OxMarco/Quiesco/README.md

<div align="center">

<picture>
  <source media="(prefers-color-scheme: dark)" srcset=".github/assets/banner-dark.svg">
  Quiesco: an open-source bedroom environment monitor
</picture>

<br><br>





<br>




**[Build your own](#-build-your-own)** · **[Hardware](hardware/)** · **[Firmware](firmware/)** · **[App](app/)**

</div>

---

Quiesco is a pocket-sized monitor made for the room you sleep in. It measures
**CO₂, temperature, humidity, light and noise**, shows them on an e-ink screen
that reads from across the room, and syncs every night to your phone over
Bluetooth. There is no Wi-Fi, no cloud and no account: your data stays yours.

Everything is open. This repository holds the PCB, the case, the firmware and
the companion app, so you can build one from scratch, reflash it from the
Arduino toolchain, or take it apart and make it your own.

Quiesco is a product of [Impossible Labs](https://impossiblelabs.xyz).

<p align="center">
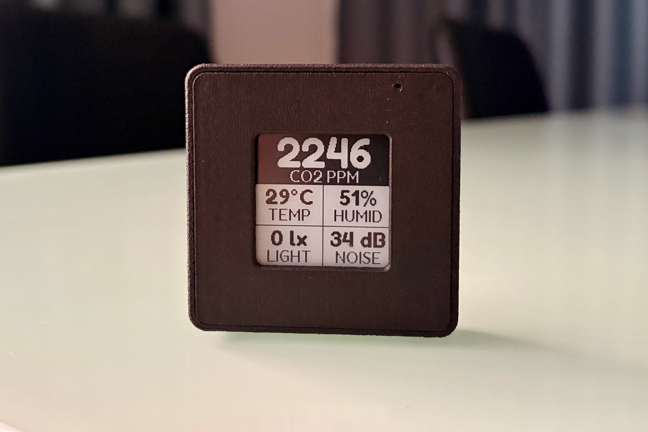
[picture p1: .github/assets/quiesco-front.jpg]
A Quiesco unit standing on a table, its e-ink screen showing CO₂, temperature, humidity, light and noise
  
</p>

<picture>
  <source media="(prefers-color-scheme: dark)" srcset=".github/assets/screens-dark.svg">
  The three e-ink screens: Face, Ledger and Bento
</picture>

## Contents

- [Why Quiesco](#-why-quiesco)
- [What it measures](#-what-it-measures)
- [How it works](#-how-it-works)
- [Specs](#-specs)
- [Build your own](#-build-your-own)
- [Upgrade firmware](#-upgrade-firmware)
- [Repository map](#-repository-map)
- [Roadmap](#-roadmap)
- [The story behind it](#-the-story-behind-it)
- [Contributing](#-contributing)
- [Licence](#-licence)

## 🌙 Why Quiesco

Environmental monitors have boomed: Aranet, Airvalent and friends made CO₂
tracking friendly. But they are general-purpose. They watch the air, and
little else, against office standards.

Quiesco is built for the **bedroom**. Light and noise matter as much as CO₂ and
temperature for a good night, so it measures all of them and judges each one
against a comfort band. Every reading is **actionable**:

| When it says… | …you can |
|---|---|
| CO₂ is high | open a window or run ventilation |
| too warm, too cold | adjust heating, cooling or bedding |
| too dry, too damp | humidify or dehumidify |
| too much light | close the blinds or wear a sleep mask |
| too loud | check the insulation or reach for earplugs |

And unlike commercial devices, it is **completely open and unlocked**: it runs
the Arduino bootloader, so you can change the firmware with the Arduino IDE or
your favourite editor.

## 📊 What it measures

| Reading | Sensor | Comfortable | Warn | Bad |
|---|---|---|---|---|
| CO₂ | Sensirion **SCD41** (photoacoustic NDIR) | ≤ 800 ppm | 800–1000 ppm | > 1000 ppm |
| Temperature | Bosch **BME280** | 16–20 °C | 14–16 · 20–24 °C | < 14 · > 24 °C |
| Humidity | Bosch **BME280** | 40–60 % | 30–40 · 60–70 % | < 30 · > 70 % |
| Noise | Knowles **SPH0641LU4H-1** PDM mic, dB(A) Leq over ~7 s | ≤ 45 dB | 45–55 dB | > 55 dB |
| Light | Vishay **VEML7700** | informational | | |
| Pressure | Bosch **BME280** | informational; also compensates CO₂ | | |

The same bands drive the e-ink screen and the app, so the phone and the panel
always agree. The full policy is in [`firmware/UI.md`](firmware/UI.md#3-comfort-bands).

> [!IMPORTANT]
> Keep the unit out of direct sunlight. Sun on the case heats the sensors, so
> temperature reads several degrees high and humidity reads low. On a test
> bench, afternoon sun pushed the reading to 36 °C. A shaded bedside table or
> shelf, away from radiators and air vents, gives readings you can trust.

## ⚙ How it works

```mermaid
flowchart LR
    subgraph unit["Quiesco unit · nRF52840"]
        direction TB
        rail["Switched sensor rail"] --> sensors["SCD41 · BME280<br/>VEML7700 · PDM mic"]
        sensors --> cycle["Measurement cycle"]
        cycle --> flash[("8 MB flash<br/>sample log")]
        cycle --> eink["1.54″ e-ink<br/>Face · Ledger · Bento"]
        cycle --> ble["BLE service"]
        flash --> ble
    end
    ble <-- "authenticated, enrolled over USB" --> app["Companion app<br/>iOS · Android"]
    app --> db[("SQLite<br/>on your phone")]
```

Every interval (1, 5, 10 or 30 minutes; default **5 minutes**) the unit powers
up its sensor rail, measures everything, applies your calibration offsets,
appends the reading to its on-board log, redraws the e-ink panel only if the
picture changed, then powers the rail down and sleeps. A sensor that fails is
reported as unavailable, and the cycle carries on without it.

The app enrols with a unit while it is on USB power, using a six-digit code
shown on the panel. After that it sets the clock, downloads the log, charts
each night and lets you pick the screen or calibrate the sensors. One phone
can hold several units, each with its own name and sleep window.

## 📐 Specs

<p align="center">
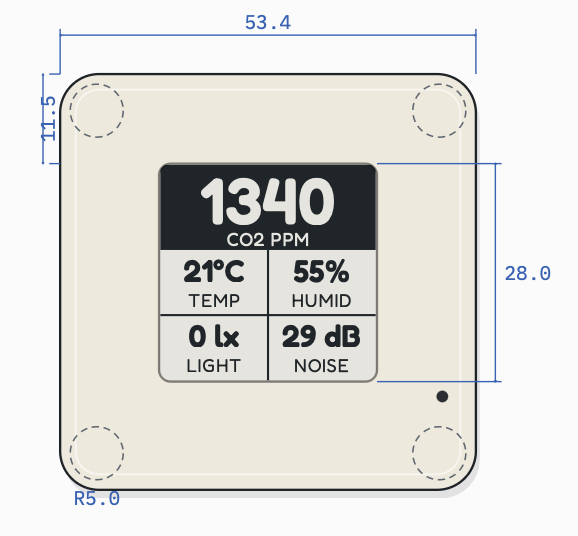
[picture p2: .github/assets/enclosure-front.png]
Front view of the enclosure: 53.4 mm square with 5 mm corner radii and a 28 mm e-ink window showing CO₂, temperature, humidity, light and noise
  
</p>

<p align="center">
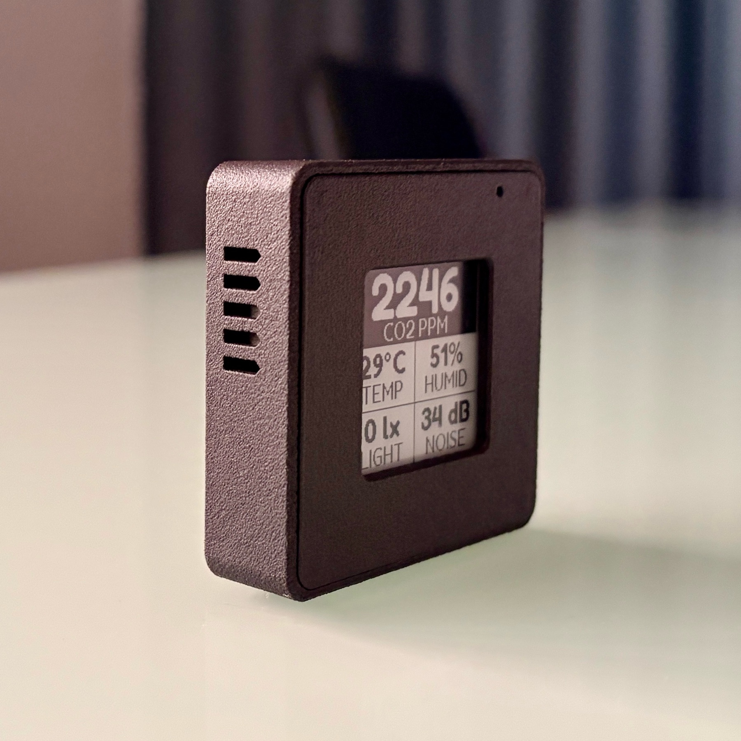
[picture p3: .github/assets/quiesco-angle.jpg]
Three-quarter view of the black nylon case showing the side ventilation slots
  
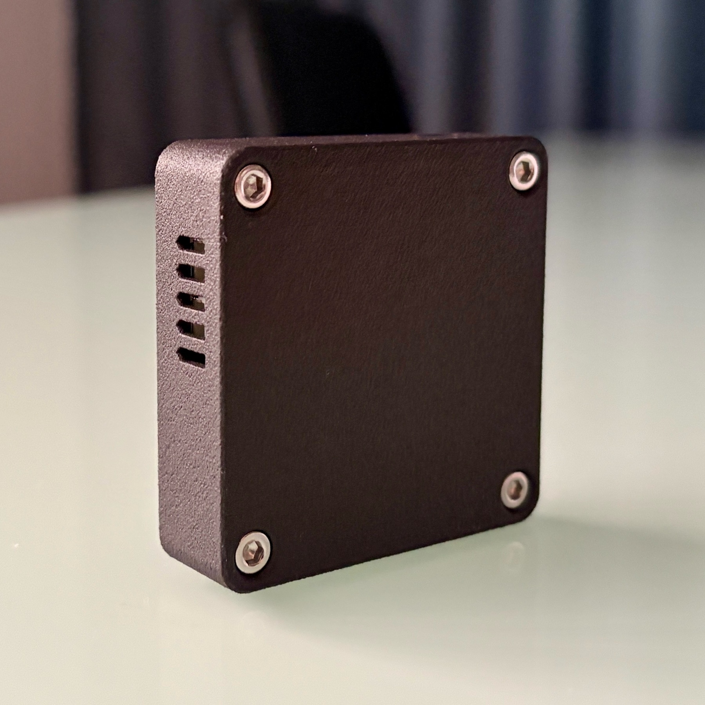
[picture p4: .github/assets/quiesco-back.jpg]
Back of the case, closed with four M3 socket-head screws
  
</p>

| | |
|---|---|
| **MCU** | Nordic nRF52840 on a Seeed XIAO nRF52840 Plus module, Arduino bootloader |
| **Connectivity** | Bluetooth Low Energy; only an enrolled phone can read data or change settings |
| **Sensors** | CO₂, temperature, humidity, pressure, light, noise |
| **Display** | GoodDisplay GDEW0154T8D, 1.54″ 152 × 152 e-ink, holds its image unpowered |
| **Storage** | Winbond W25Q64 8 MB SPI NOR flash (config + sample log) |
| **Power** | 3.7 V ~400 mAh LiPo (453035), USB-C charging, switched peripheral rail |
| **Expansion** | JST I²C and UART headers |
| **Case** | Two-part enclosure, MJF-printed in black PA12 nylon, four M3 screws ([why nylon](hardware/README.md#material)) |

## 🛠 Build your own

A Quiesco takes an afternoon to put together once the parts arrive. Each step
links to the folder with the details.

### What you need

- The **PCBA**: the board from [`hardware/`](hardware/), ordered assembled
- A **GDEW0154T8D** 1.54″ e-ink panel (24-pin FPC)
- A **3.7 V LiPo** that matches your board's battery connector: a ~400 mAh 453035
  (4.5 × 30 × 35 mm) with a **JST SH 1.0 2-pin** lead for the JST SH board, or
  the certified **EEMB LP402535-PCM-PTC-LD/-A22852** for the Minitek board (see
  [`hardware/`](hardware/README.md))
- A **3D-printed case** (MJF PA12 nylon, dyed black) and **4 × M3×10 socket-head screws**
- A USB-C cable, a Mac or Linux machine, and a phone with Bluetooth

### Steps

Start by cloning the repository:

```sh
git clone https://github.com/OxMarco/Quiesco.git
cd Quiesco
```

1. **Order the board** → [`hardware/`](hardware/README.md#order-the-board)
   Send the Gerbers, BOM and pick-and-place files to a PCB assembly service.
2. **Print the case** → [`hardware/`](hardware/README.md#print-the-case)
   The STL is ready to slice; STEP files are there if you want to modify it.
3. **Assemble** → [`hardware/`](hardware/README.md#assemble)
   Seat the display, plug in the battery, close the case.
4. **Test the unit** → [`firmware/`](firmware/README.md#test-a-new-unit)
   Flash the factory test sketch and check every part reports `PASS`.
5. **Flash the firmware** → [`firmware/`](firmware/README.md#quick-start)
   `make build`, then upload over USB.
6. **Install the app** → [`app/`](app/README.md#run-it)
   Build it onto your phone, plug the unit into USB and pair.

## ⬆ Upgrade firmware

No software needed, on macOS, Windows or Linux. Plug the unit into a
computer, tap **Settings → your unit → Update firmware** in the app, and a drive called
`XIAO-BOOT` appears. Copy `quiesco-X.Y.Z.uf2` onto it, and the unit restarts
with the new firmware. Settings, enrolled phones, calibration and history
are kept.

Troubleshooting, units without the app option, and making a release:
[`AGENT.md`](AGENT.md).

## 🗺 Repository map

| Folder | What's inside | Read this |
|---|---|---|
| [`hardware/`](hardware/) | Altium sources, schematic PDF, Gerbers, BOM, pick-and-place, case STL/STEP | [hardware/README.md](hardware/README.md) |
| [`firmware/`](firmware/) | Arduino C++ firmware for the nRF52840, test sketches, host tests and tools | [firmware/README.md](firmware/README.md) |
| [`app/`](app/) | Expo / React Native companion app for iOS and Android | [app/README.md](app/README.md) |
| [`landing/`](landing/) | The [quiesco.rest](https://quiesco.rest) website (Astro) | [landing/README.md](landing/README.md) |

Going deeper:

- [`firmware/HARDWARE.md`](firmware/HARDWARE.md): the board as the firmware sees it, pin map, traps and debugging
- [`firmware/SOFTWARE.md`](firmware/SOFTWARE.md): firmware architecture and features
- [`firmware/UI.md`](firmware/UI.md): the e-ink screens, pixel by pixel
- [`firmware/src/protocol/PROTOCOL.md`](firmware/src/protocol/PROTOCOL.md): the BLE contract between unit and app
- [`AGENT.md`](AGENT.md): updating a unit's firmware (copy a file onto its USB drive)

## 🧭 Roadmap

- [x] PCB v1, assembled and tested
- [x] Measurement cycle with all sensors, calibration and CO₂ forced recalibration
- [x] E-ink screens: Face, Ledger and Bento
- [x] Persistent sample log on the on-board flash
- [x] BLE protocol with phone enrolment and authentication
- [x] Companion app: live reading, night charts, calibration
- [ ] BLE tested on air: iPhone and Mac done (2026-10-07), Android still to test
- [x] Firmware updates over USB, started from the app: copy one file, no software ([`AGENT.md`](AGENT.md))
- [ ] Measured power budget and battery life
- [x] App: more than one unit per phone, each with its own name and sleep window
- [ ] App on the App Store and Google Play
- [ ] Units for sale — *coming soon*
- [ ] Later: Quiesco XL, with PM2.5, PM10 and more sensors for fuller air-quality control, and a bigger screen

## 📖 The story behind it

<details>
<summary>Why I built Quiesco</summary>

<br>

Despite having studied electrical engineering and physics, I never had the
chance to work on electronics outside of university. My main job for the past
few years has been in fintech, mostly on software architecture. Yet I have
always wanted to launch my own product.

I own an Airvalent and a couple of Xiaomi environmental sensors and had a
chance to review the Aranet too, yet I felt these little devices could
definitely do more. That's why, in early 2026, I decided to dedicate part of my
free time to building Quiesco from the ground up.

The choice of sensors was tough. There are clear contenders on the market, but
most come with obvious drawbacks, like relying on the BME280's self-heating
element for the primary temperature reading, or gas sensors that draw too much
current for a rather generic value like VOC. So temperature, humidity and pressure
come from a BME280 on the switched rail, never self-heated, and the SCD41 is
used for CO₂ only.

**I wanted data that is actionable:** high CO₂ → ventilate; too much light →
wear a sleep mask; too much noise → check the acoustic insulation or use
earplugs.

</details>

## 🤝 Contributing

Issues and pull requests are welcome, from a typo to a new screen.

- **Firmware:** run `make verify` in `firmware/` before opening a PR; it checks
  the source policy and runs the host tests.
- **App:** run `npm test`, `npx tsc --noEmit` and `npx expo lint` in `app/`.
- **Protocol:** a change to the BLE contract touches both sides. Update
  [`PROTOCOL.md`](firmware/src/protocol/PROTOCOL.md), the firmware codec and
  the app's `src/protocol/` together; the golden vectors keep them honest.

## 🙏 Acknowledgements

Many thanks to the engineers at **PCBWay**, who helped tailor the PCB and the
enclosure to production standards.

## 📜 Licence

Quiesco is free and open source under the [GNU General Public License v3.0](LICENSE).
Third-party components are listed in
[`firmware/THIRD_PARTY_NOTICES.md`](firmware/THIRD_PARTY_NOTICES.md).

<div align="center">
<br>
<sub>Quiesco is a product of <a href="https://impossiblelabs.xyz">Impossible Labs</a> · <a href="https://quiesco.rest">quiesco.rest</a></sub>
</div>
