OxMarco/Quiesco/compliance/xiao-nrf52840-plus/certificates/102010672-UKDOC.pdf

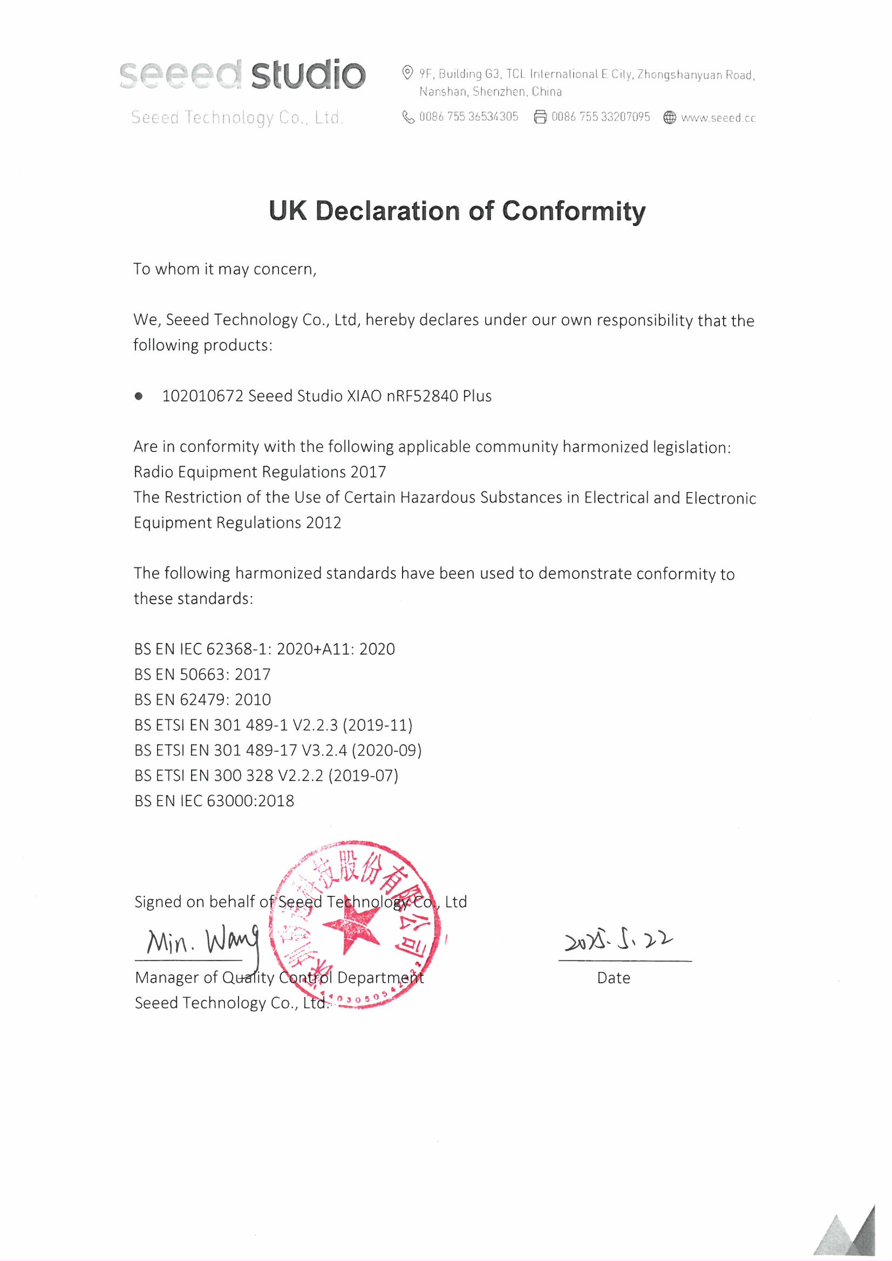
[picture p7: page 1]
