OxMarco/Quiesco/hardware/pcb-minitek/manufacturing/bom.xlsx

Manufacturer | Comment | Mfg Part # | Designator | Footprint | LibRef | Quantity | Type
FOJAN(富捷) | 0.1uF/50V | FCC0603B104K500CT | C1, C3, C5, C7, C19 | C 0603 | CAP | 5
SAMSUNG(三星) | 10uF/10V | CL10A106MP8NNNC | C2, C4, C8, C20 | C 0603 | CAP | 4
HRE(芯声) | 1uF/50V | CGA0603X5R105K500JT | C6, C9, C11, C13, C14, C15, C16, C17, C18 | C 0603 | CAP | 9
SAMSUNG(三星) | 4.7uF/50V | CL21A475KBQNNNE | C10, C12 | C 0805 | CAP | 2
LRC(乐山无线电) | MBR0530 | LMBR0530ET1G | D1, D2, D3 | SOD-323 | D 1N4148 | 3
GCT | HC-FPC-05-09-24RLTAG | FFC2B28-24-G | J1 | GCT_FFC2B28-24-G | FFC2B28-24-G | 1
Amphenol ICC | 10144041-02011LF | 10144041-02011LF | J2 | AMPHENOL_10144041-02011LF | AMPHENOL_10144041-02011LF | 1
JST | SM04B-GHS-TB(LF)(SN) | SM04B-GHS-TB(LF)(SN) | J3, J4 | JST_SM04B-SRSS-TB(LF)(SN) | SM04B-GHS-TB(LF)(SN) | 2
YJYCOIN(益嘉源) | 10uH/1A | CD32YP0302-100M | L1 | CD31 | INDUCTOR | 1
HKT(合科泰) | AO3401 | AO3401 | Q1 | SOT23-3N | AO3401 | 1
TECH PUBLIC(台舟) | SI1308EDL | SI1308EDL | Q2 | SOT323 | AO3400 | 1
NC | NC | NC | R1, R2, R3, R5, R6, R7, R8, R9 | R 0603 | RES2 | 8
FOJAN(富捷) | 0R | FRC0603P000 TS | R4 | R 0603 | RES2 | 1
YAGEO(国巨) | 10K | RT0603BRD0710KL | R10 | R 0603 | RES2 | 1
UNI-ROYAL(厚声) | 1M | 0603WAF1004T5E | R11 | R 0603 | RES2 | 1
UNI-ROYAL(厚声) | 0.47R | CS03W5F470LT5E | R12 | R 0603 | RES2 | 1
UNI-ROYAL(厚声) | 100R | PS03W4F1000T5E | R13 | R 0603 | RES2 | 1
YAGEO(国巨) | 4.7K | RT0603BRD074K7L | R14, R15 | R 0603 | RES2 | 2
NC | PAD 1.2mm | NC | T1, T2, T3, T4, T5, T6 | TEST 1.2 | TEST | 6
Winbond(华邦) | W25Q64JVSSIQ | W25Q64JVSSIQ | U1 | SOIC127P790X216-8N | W25Q64BVSSIG | 1
Bosch(博世) | BME280 | BME280 | U2 | PSON65P250X250X100-8N | BME280 | 1
Seeed Studio | XIAO-nRF52840-Plus | XIAO-nRF52840-Plus | U3 | XIAO-nRF52840-Plus | XIAO-nRF52840-Plus | 1
Knowles(楼氏) | SPH0641LU4H-1 | SPH0641LU4H-1 | U4 | MIC_SPH0641LU4H-1 | SPH0641LU4H-1 | 1
VISHAY(威世) | VEML7700-TR | VEML7700-TR | U5 | XDCR_VEML7700-TR | VEML7700-TR | 1
Sensirion(瑞士盛思锐) | SCD41-D-R1 | SCD41-D-R1 | U6 | SCD4x | SCD4x | 1
鼎欣源科技电子 | 3.7V 280mAh | 3030-3.7V-280mAh | Battery | 303030 | link (https://item.taobao.com/item.htm?id=582174247712) | 1
优信电子 | SH1.0-2P | SH1.0/2P/10CM单头 | Wire | SH1.0-2P | link (https://item.taobao.com/item.htm?&id=565360096163) | 1
GooDisplay（佳显电子） | GDEW0154T8D | GDEW0154T8D | Screen | 1.54inch-0.5mmx24Pin | link (https://www.good-display.cn/product/205.html) | 1
