OxMarco/Quiesco/hardware/case/assembly.step

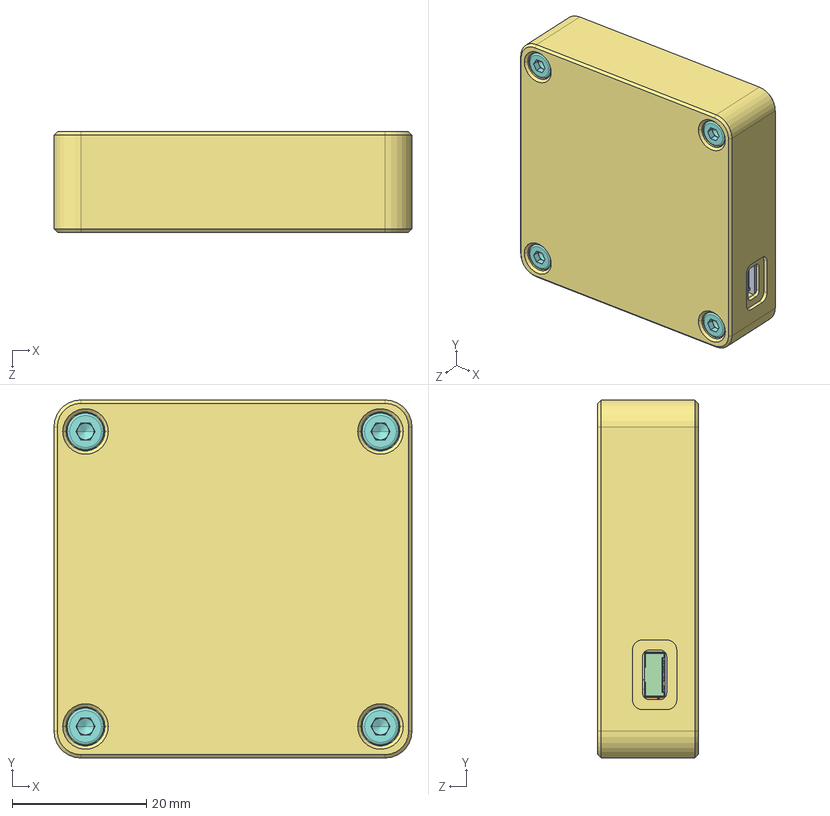
[picture p8: CAD file, 2026-10-31]
hardware/case/assembly.step
53.4 x 53.4 x 15.0 mm
149693-00_SCD4x_Datasheet
BOSS-EXTRUDE14_8_
BOSS-EXTRUDE7_4_
BOSS-EXTRUDE7_3_
BOSS-EXTRUDE14_4_
BOSS-EXTRUDE14_2_
BOSS-EXTRUDE14_11_
BOSS-EXTRUDE7_7_
BOSS-EXTRUDE14_9_
BOSS-EXTRUDE14_3_
BOSS-EXTRUDE14_7_
MIRROR2
BOSS-EXTRUDE14_5_
BOSS-EXTRUDE14_12_
BOSS-EXTRUDE7_8_
BOSS-EXTRUDE7_1_
BOSS-EXTRUDE14_10_
BOSS-EXTRUDE7_9_
BOSS-EXTRUDE14_6_
BOSS-EXTRUDE14_1_
BOSS-EXTRUDE7_6_
BOSS-EXTRUDE7_2_
CUT-EXTRUDE5
BOSS-EXTRUDE7_5_
Pins
CAP x 2
ANT1
Silkscreen
CAP 3
LED
USR
Shield
LGA-8_BME280_BL
R 0603-0 x 15
LOGO__ x 15
User Library-SOT323 (SC70-3)-1_K_X_F6rper_1
User Library-SOT323 (SC70-3)-1_Beschriftung_1
User Library-SOT323 (SC70-3)-1_Pins_1 x 3
SOT23-3-1
SOT23-3 ______ x 3
LOGO__0.15
CD31-2
LOGO__-3
SOD-323-4 x 3
LOGO__________.____ x 3
LOGO__-5 x 18
C 0603-6 x 18
LOGO__-7 x 2
C 0805-8 x 2
Extruded
Extruded-9
零件63^L-1K1W1007851A
hexagon socket head cap screws gb_GB_FASTENER_SCREWS_HSHCS M3X10-N x 4
零件64^L-1K1W1007851A
