OxMarco/Quiesco/hardware/case/v2/case-v2.step

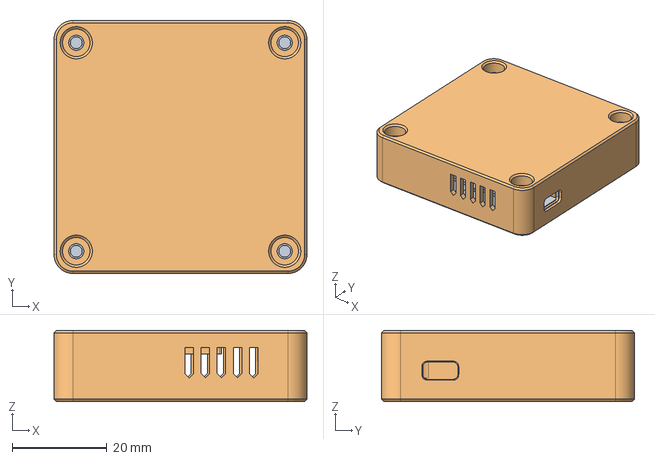
[picture p9: CAD file, 2026-10-31]
hardware/case/v2/case-v2.step
53.4 x 53.4 x 15.0 mm
