OxMarco/Quiesco/(list of files, cad)

Other CAD files:
hardware/case/case_v2.STL
hardware/case/L-1K1W1007851A_CASE.STEP
hardware/case/v1/case-v1.stl
