OxMarco/Quiesco/hardware/assembly/PCB Manufacturing Process Specification.xlsx

PCB Manufacturing Process Specification PCB 加工工艺说明书
File Name： 项目名称 | L-1K1W1007851A
1. General Manufacturing Information（基本工艺信息）
Layers 层数 | 2 layer (2层） |  | PCB Material PCB材料 | FR4
Finished Board Thickness(mm) 成品板厚 | 1.6mm |  | Board Thickness Tolerance板厚公差 | ±10%
Finished Board Size(mm) 成品尺寸 | 50*50MM |  | Dimensional Tolerance 尺寸公差 | ±0.2
PCB Type 板子类型 | Rigid PCB (刚性板) |  | Paneling Method 拼版方式 | 单板交付 Single board delivery
Acceptance Criteria 验收标准 | IPC-6012 II |  | PCB Warpage 翘曲度 | 1.50%
Surface Finish 表面处理 | HASL with lead 有铅喷锡 |  | Via Process 过孔方式 | Tenting vias 过孔盖油
Soldermask 阻焊颜色 | Green 绿色 |  | Silkscreen 丝印 | White 白色
Special Markings 特殊标记 | None |  | Cycle Identification 周期标识 | No 不加
2. Stackup Information（叠层信息）
TOP | ======================================= |  |  | 1 Oz+Plating
 | Core | FR4
BOTTOM | ======================================= |  |  | 1 Oz+Plating
3.Impedance Information（阻抗信息）：（无阻抗要求）
Impedance Type 阻抗类型 | Impedance Value 阻抗值 | Control Layer 控制层 |  | Trace Width / Spacing (mil) 线宽/线距 | solder mask on the traces 盖油
4. Special Instructions（特殊说明）
a. Adjust the layer spacing, trace width, and trace spacing according to actual conditions, but the overall board thickness and impedance requirements must be met.（根据实际情况调整层间距、线宽和线距，但必须满足整体板厚和阻抗要求） b. The dielectric thickness between layers may be adjusted.（层间介质厚度可调整） c. Trace width may be adjusted.（线宽可调整）
