OxMarco/Quiesco/hardware/pcb-jst-sh/source/schematic.pdf

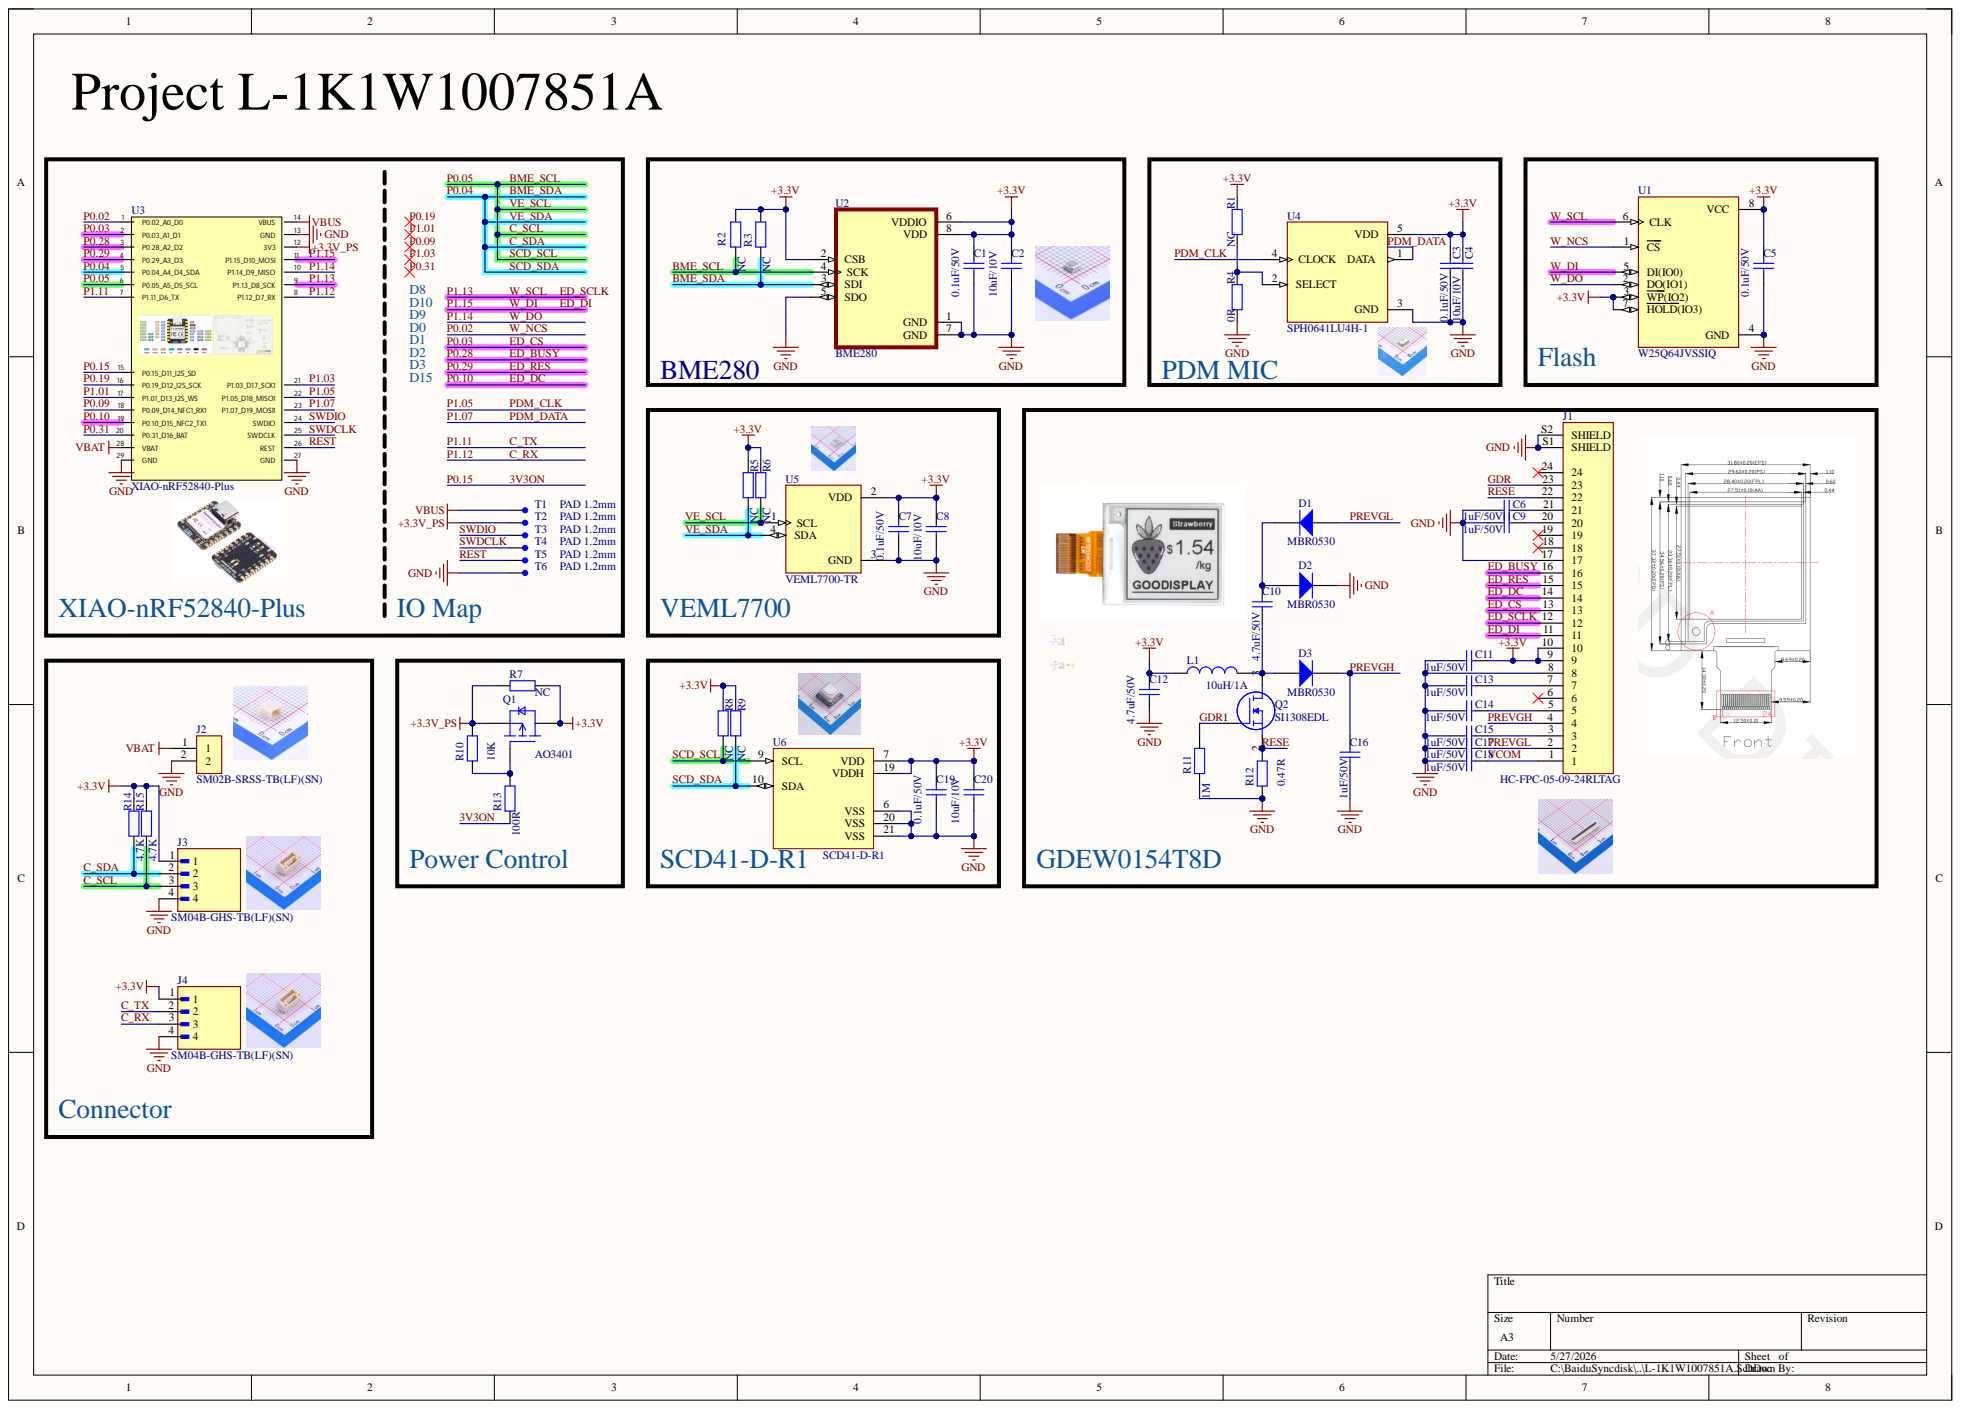
[picture p13: page 1]

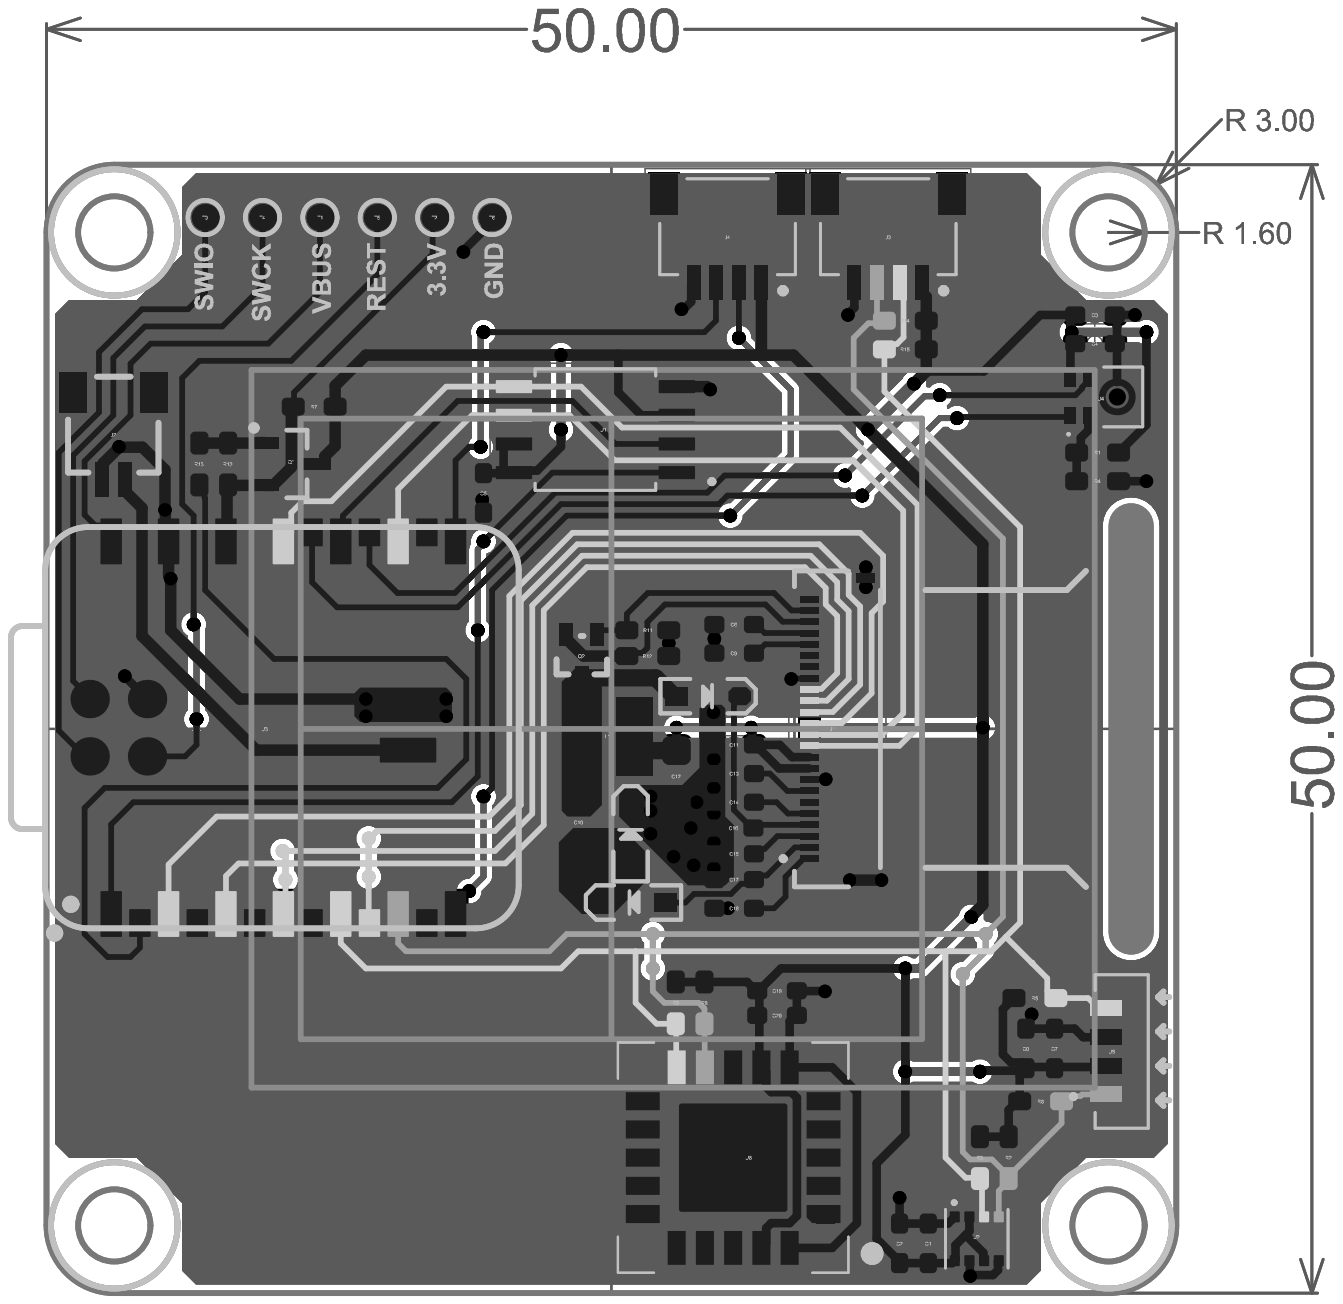
[picture p14: page 2]

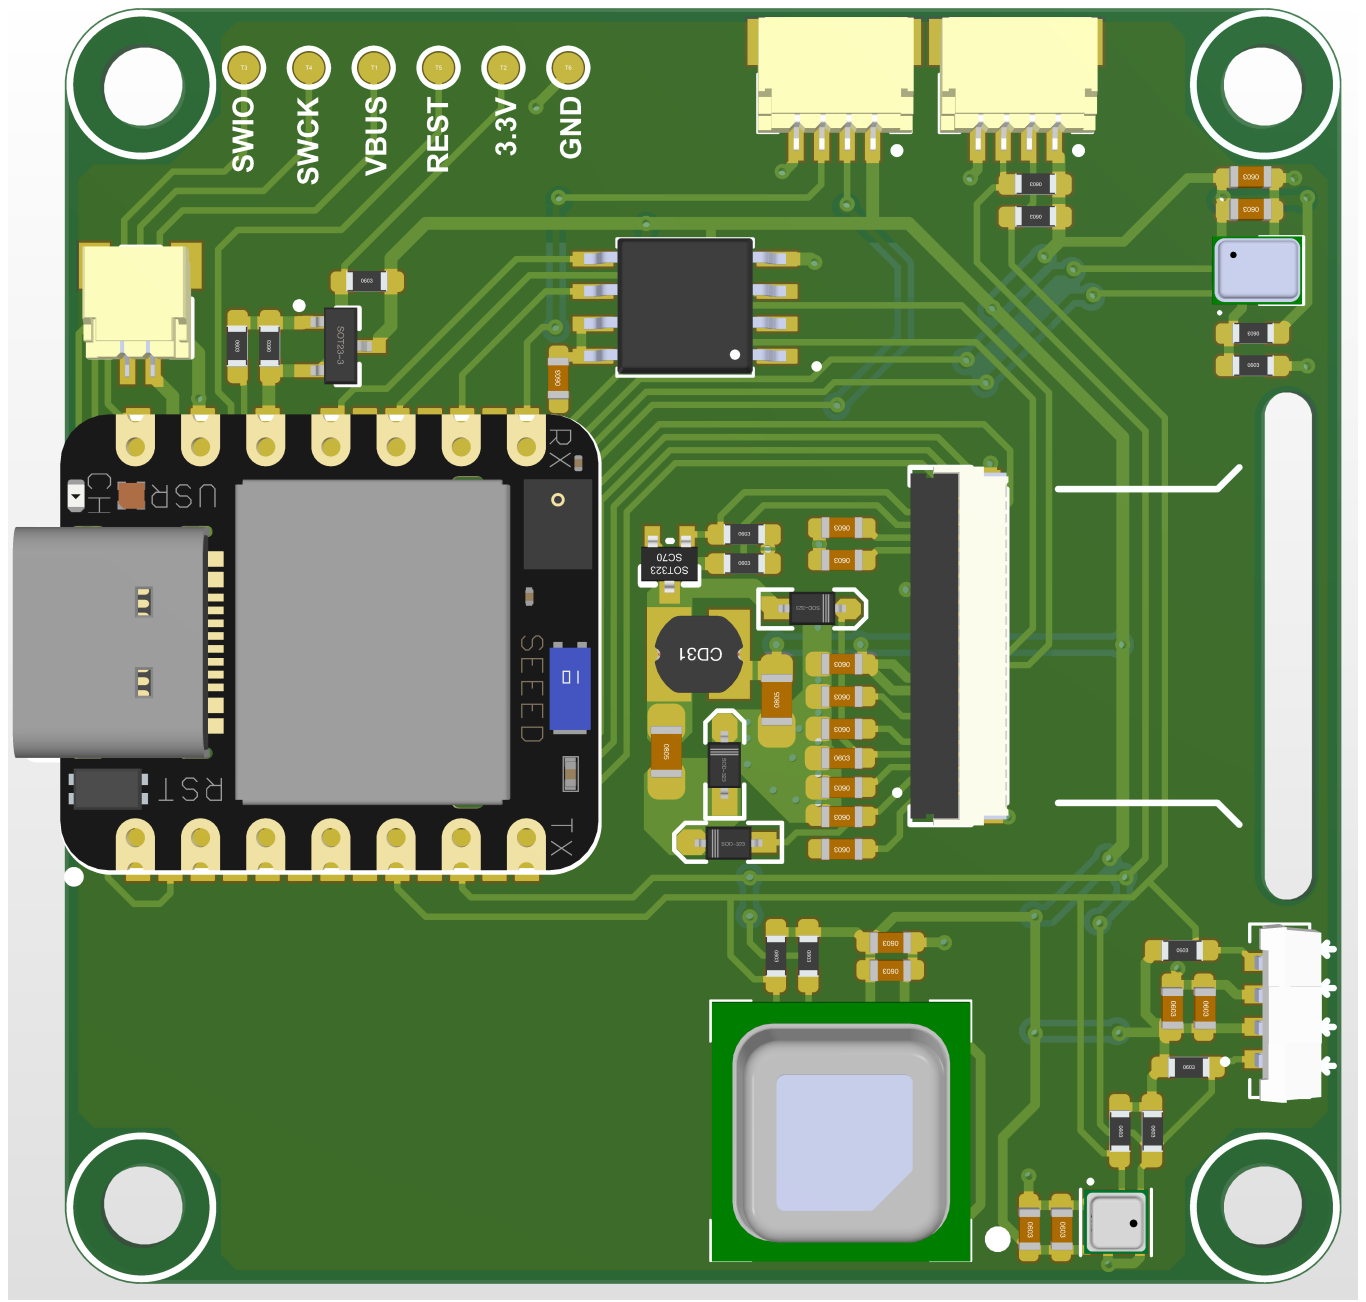
[picture p15: page 3]

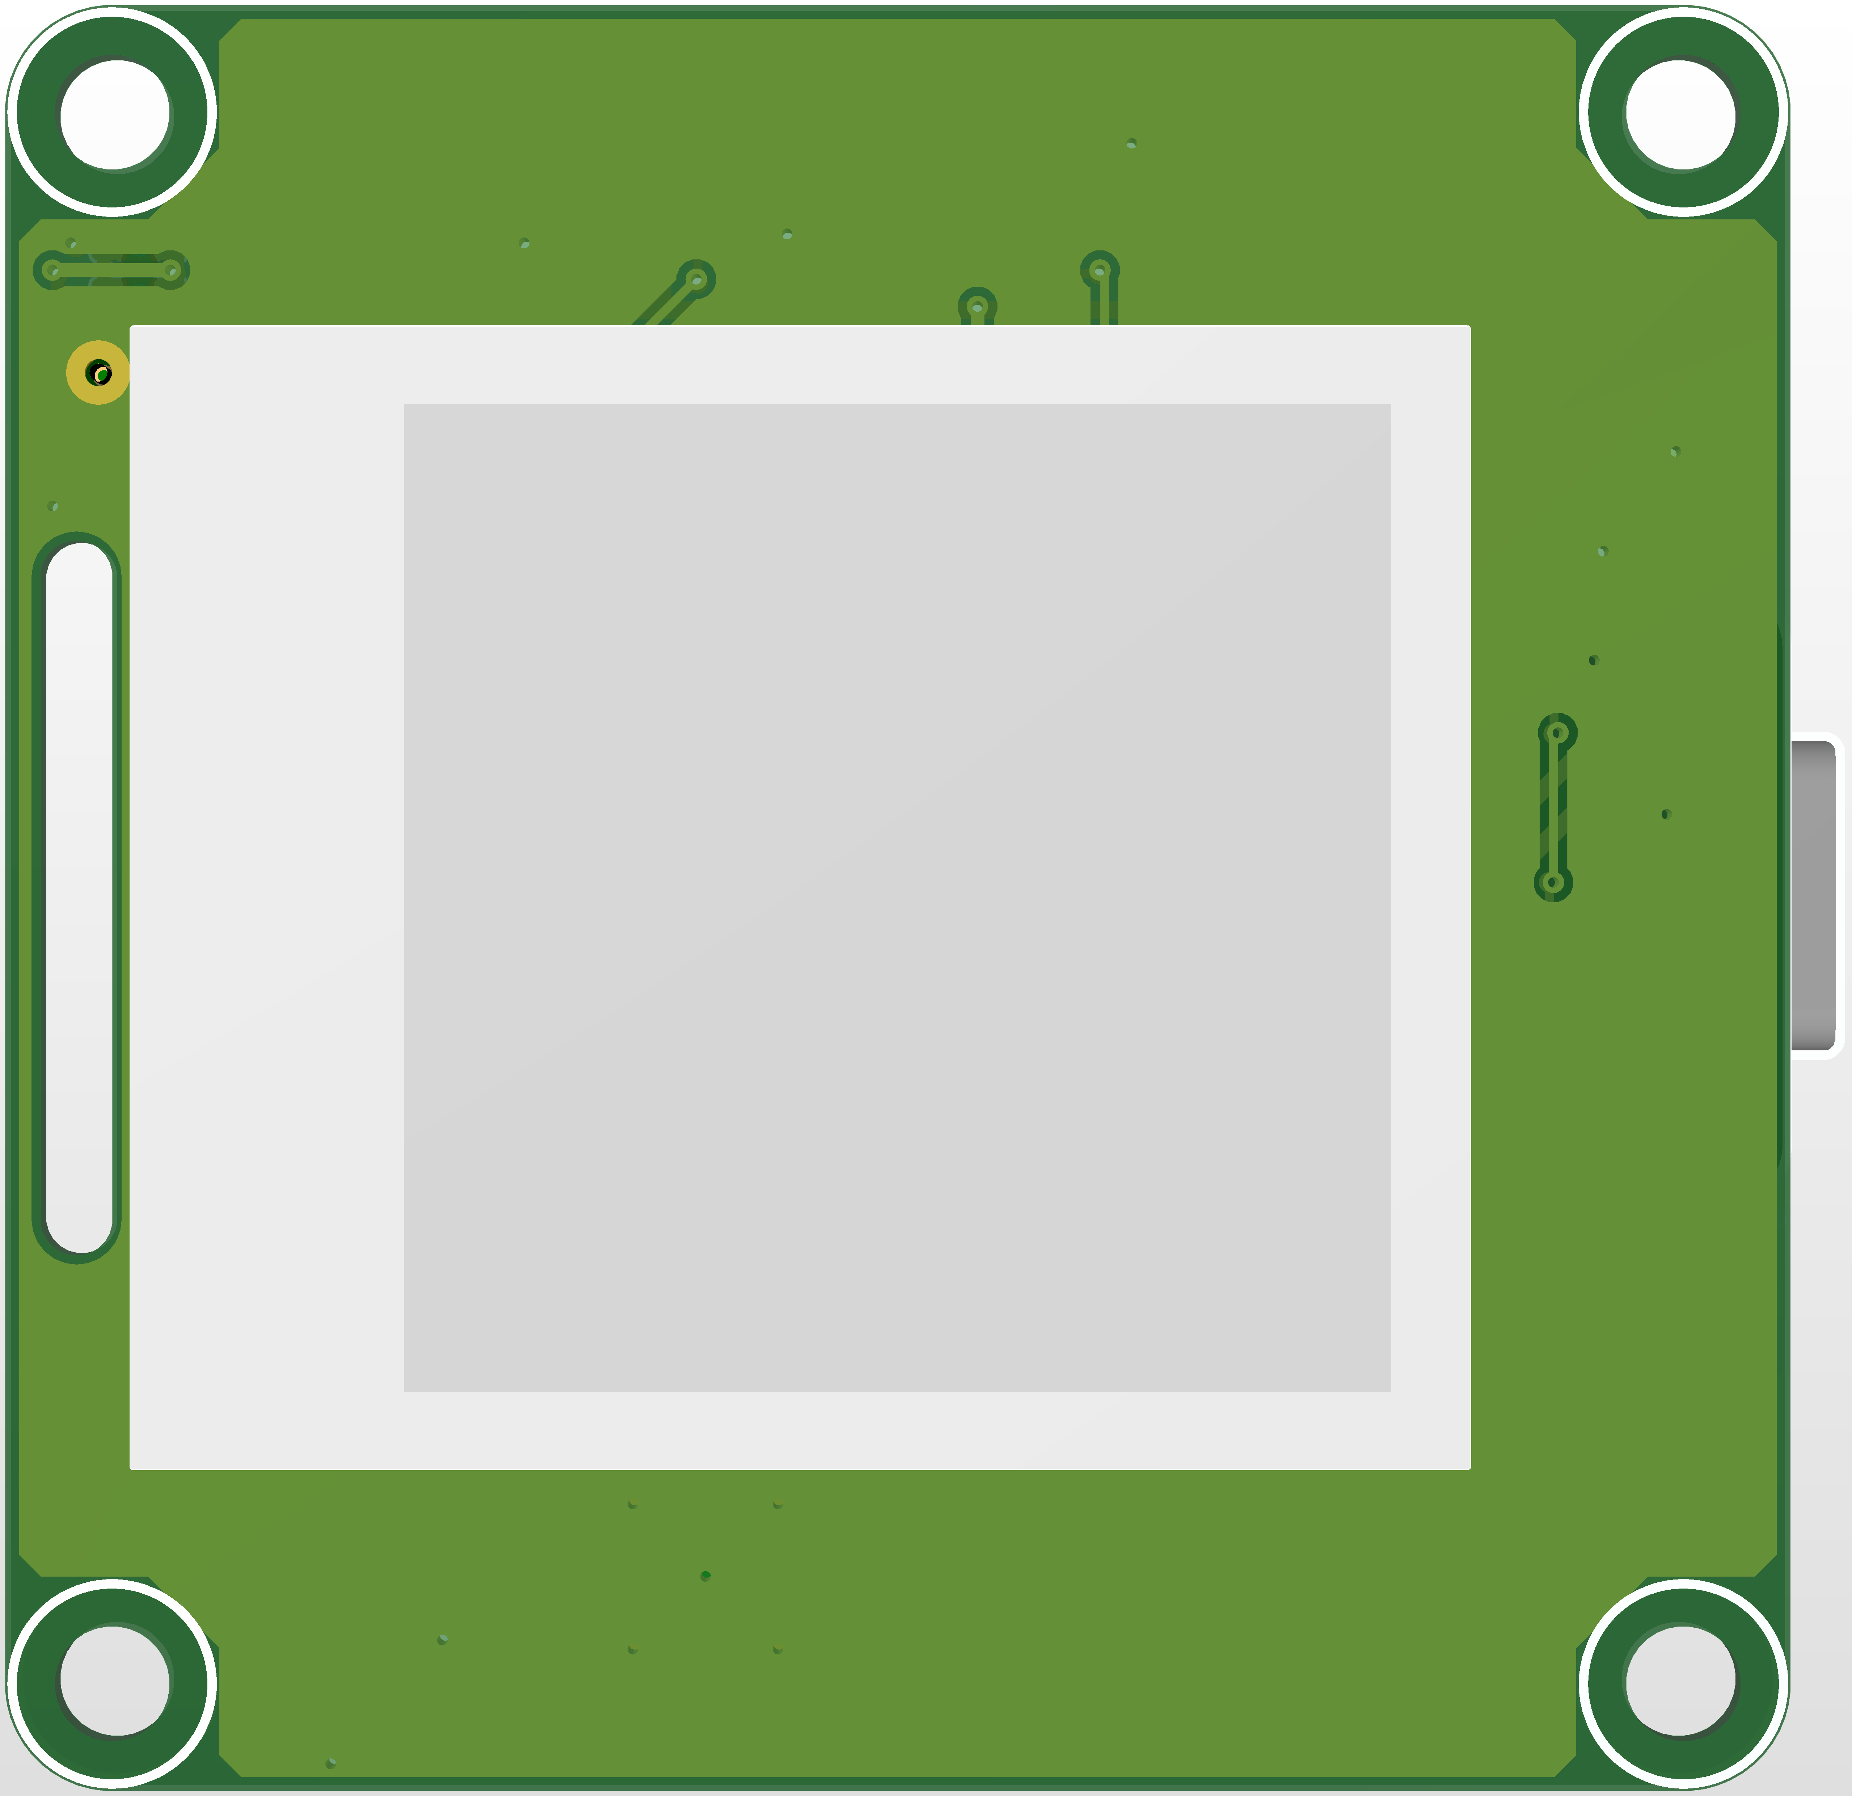
[picture p16: page 4]

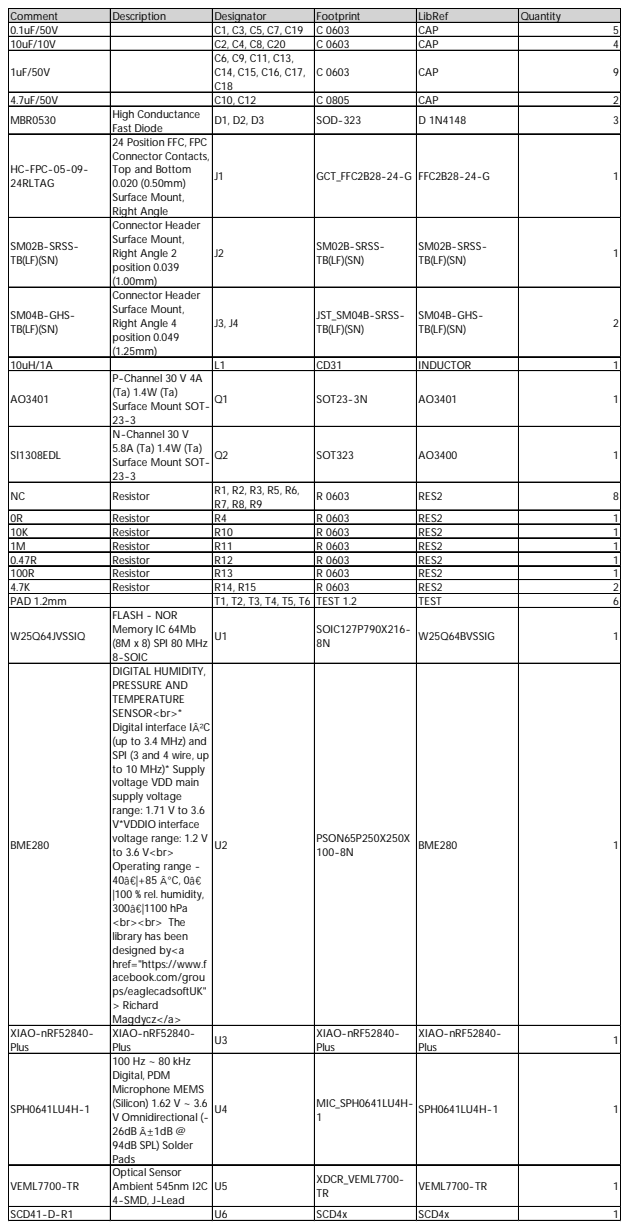
[picture p17: page 5]

Comment | Description | Designator | Footprint | LibRef | Quantity
0.1uF/50V | | C1, C3, C5, C7, C19 | C 0603 | CAP | 5
10uF/10V | | C2, C4, C8, C20 | C 0603 | CAP | 4
1uF/50V | | C6, C9, C11, C13, C14, C15, C16, C17, C18 | C 0603 | CAP | 9

4.7uF/50V | | C10, C12 | C 0805 | CAP | 2
MBR0530 | High Conductance Fast Diode | D1, D2, D3 | SOD-323 | D 1N4148 | 3

HC-FPC-05-09-24RLTAG | 24 Position FFC, FPC Connector Contacts, Top and Bottom 0.020 (0.50mm) Surface Mount, Right Angle | J1 | GCT_FFC2B28-24-G | FFC2B28-24-G | 1

SM02B-SRSS-TB(LF)(SN) | Connector Header Surface Mount, Right Angle 2 position 0.039 (1.00mm) | J2 | SM02B-SRSS-TB(LF)(SN) | SM02B-SRSS-TB(LF)(SN) | 1

SM04B-GHS-TB(LF)(SN) | Connector Header Surface Mount, Right Angle 4 position 0.049 (1.25mm) | J3, J4 | JST_SM04B-SRSS-TB(LF)(SN) | SM04B-GHS-TB(LF)(SN) | 2

10uH/1A | | L1 | CD31 | INDUCTOR | 1
AO3401 | P-Channel 30 V 4A (Ta) 1.4W (Ta) Surface Mount SOT-23-3 | Q1 | SOT23-3N | AO3401 | 1

SI1308EDL | N-Channel 30 V 5.8A (Ta) 1.4W (Ta) Surface Mount SOT-23-3 | Q2 | SOT323 | AO3400 | 1

NC | Resistor | R1, R2, R3, R5, R6, R7, R8, R9 | R 0603 | RES2 | 8

0R | Resistor | R4 | R 0603 | RES2 | 1
10K | Resistor | R10 | R 0603 | RES2 | 1
1M | Resistor | R11 | R 0603 | RES2 | 1
0.47R | Resistor | R12 | R 0603 | RES2 | 1
100R | Resistor | R13 | R 0603 | RES2 | 1
4.7K | Resistor | R14, R15 | R 0603 | RES2 | 2
PAD 1.2mm | | T1, T2, T3, T4, T5, T6 | TEST 1.2 | TEST | 6
W25Q64JVSSIQ | FLASH - NOR Memory IC 64Mb (8M x 8) SPI 80 MHz 8-SOIC | U1 | SOIC127P790X216-8N | W25Q64BVSSIG | 1

BME280 | DIGITAL HUMIDITY, PRESSURE AND TEMPERATURE SENSOR<br>* Digital interface IÂ²C (up to 3.4 MHz) and SPI (3 and 4 wire, up to 10 MHz)* Supply voltage VDD main supply voltage range: 1.71 V to 3.6 V*VDDIO interface voltage range: 1.2 V to 3.6 V<br> Operating range -40â€|+85 Â°C, 0â€ |100 % rel. humidity, 300â€|1100 hPa <br><br> The library has been designed by<a href="https://www.facebook.com/groups/eaglecadsoftUK" > Richard Magdycz</a> | U2 | PSON65P250X250X 100-8N | BME280 | 1

XIAO-nRF52840-Plus | XIAO-nRF52840-Plus | U3 | XIAO-nRF52840-Plus | XIAO-nRF52840-Plus | 1

SPH0641LU4H-1 | 100 Hz ~ 80 kHz Digital, PDM Microphone MEMS (Silicon) 1.62 V ~ 3.6 V Omnidirectional (-26dB Â±1dB @ 94dB SPL) Solder Pads | U4 | MIC_SPH0641LU4H-1 | SPH0641LU4H-1 | 1

VEML7700-TR | Optical Sensor Ambient 545nm I2C 4-SMD, J-Lead | U5 | XDCR_VEML7700-TR | VEML7700-TR | 1

SCD41-D-R1 | | U6 | SCD4x | SCD4x | 1
