OxMarco/Quiesco/compliance/xiao-nrf52840-plus/certificates/102010672-FCC.pdf

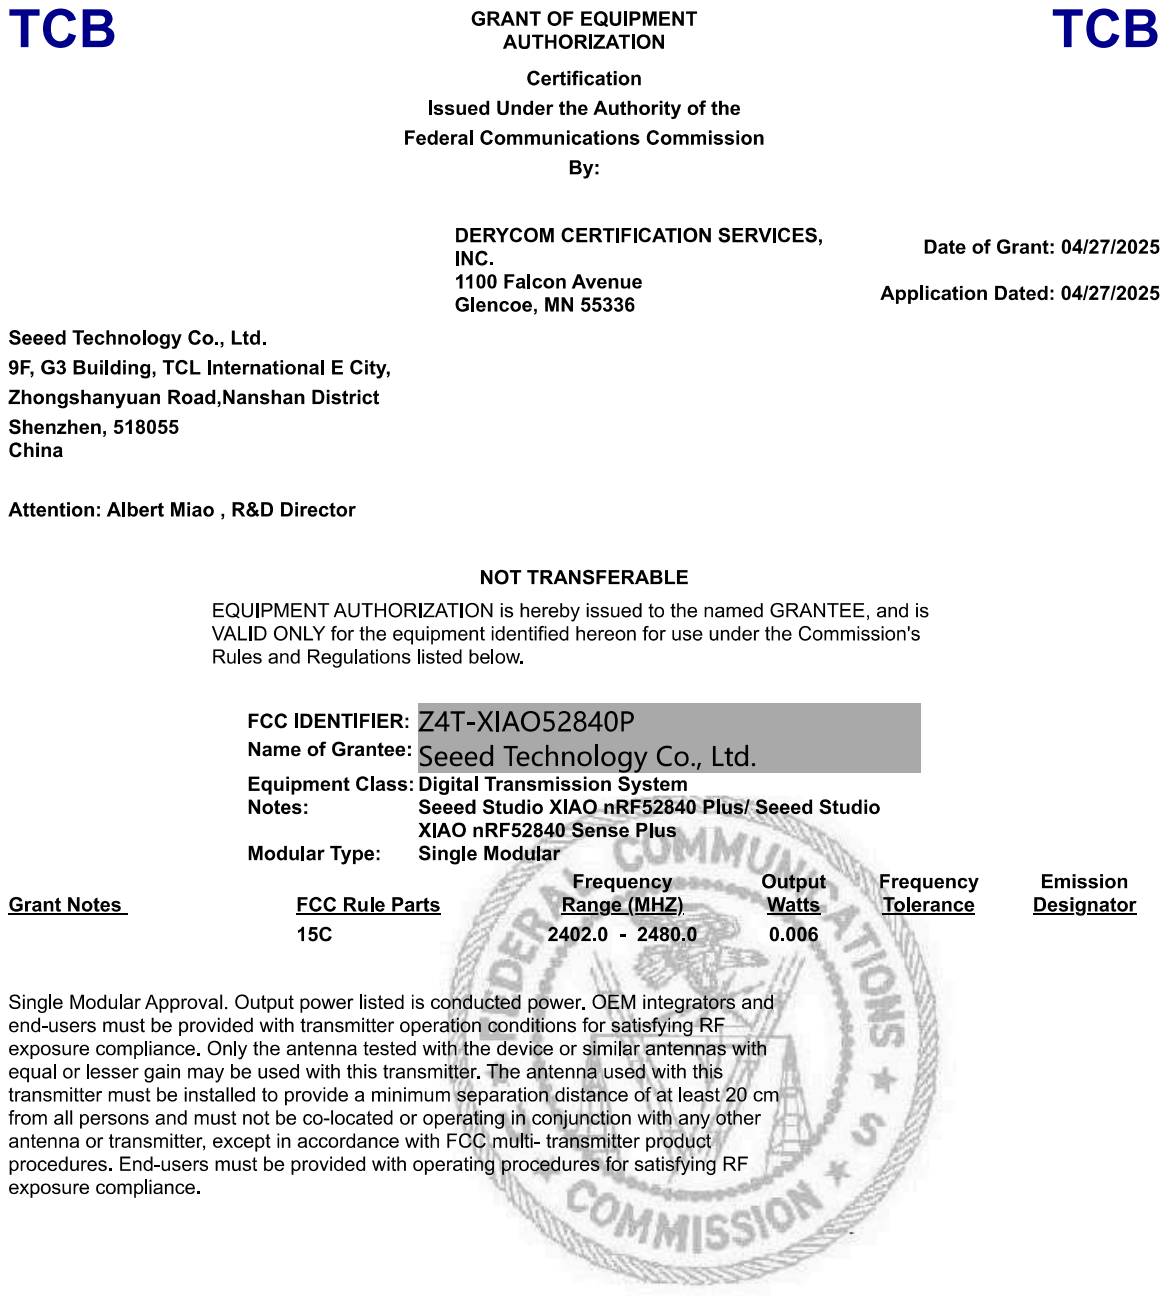
[picture p18: page 1]
