OxMarco/Quiesco/hardware/sources/old/schematic.pdf

# 8MB Flash memory

# 1.54" e-paper display

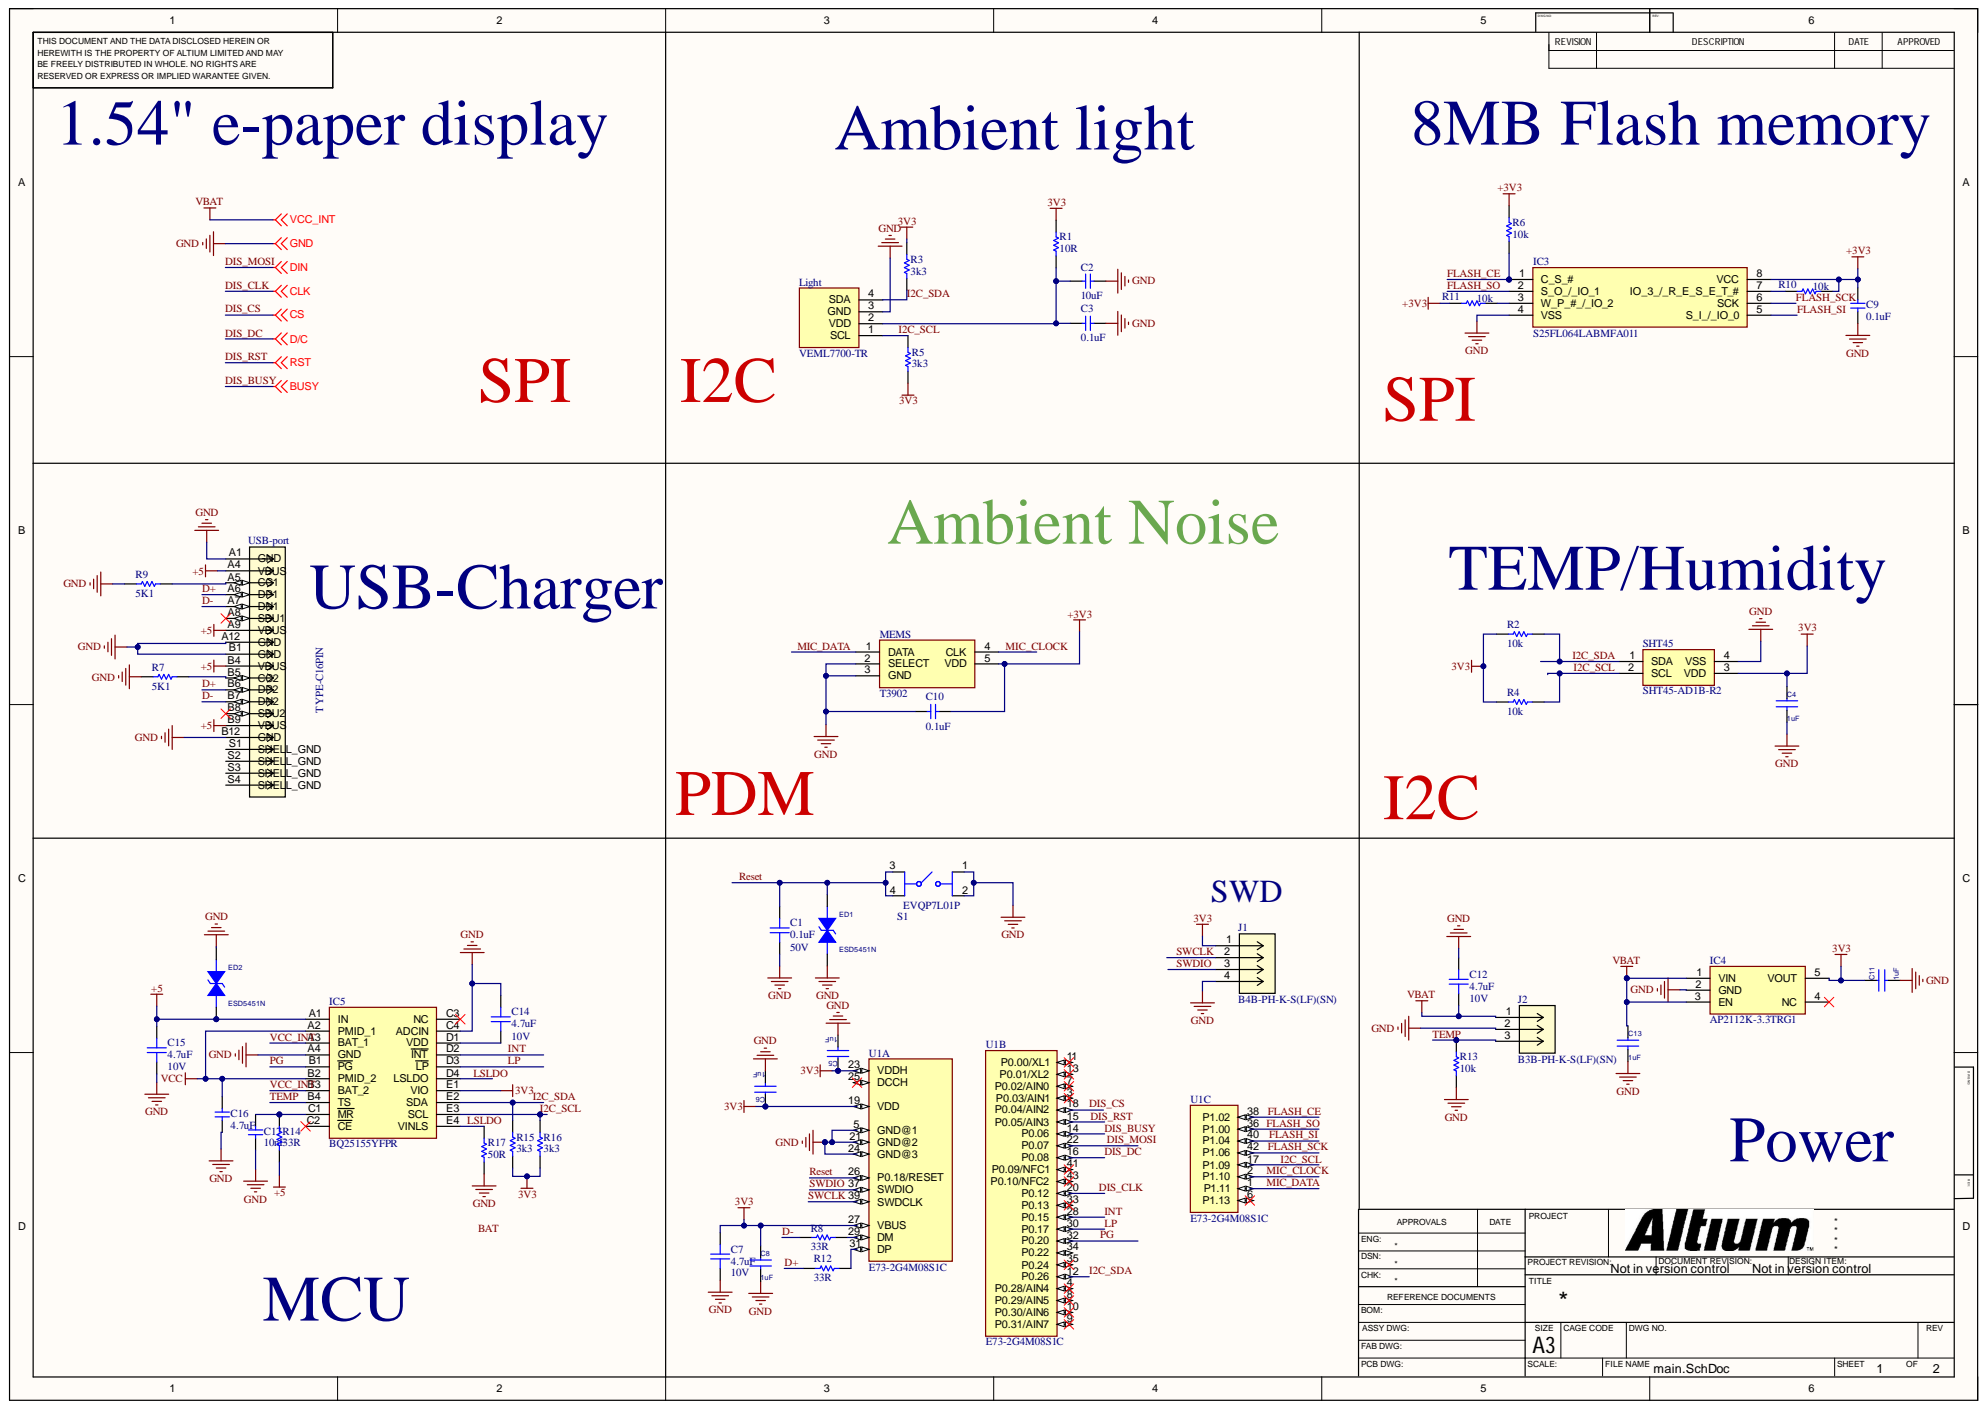
[picture p19: page 1]

1 | 2 | 3 | 4 | 5 | DWG NO: | REV: | 6

THIS DOCUMENT AND THE DATA DISCLOSED HEREIN OR HEREWITH IS THE PROPERTY OF ALTIUM LIMITED AND MAY BE FREELY DISTRIBUTED IN WHOLE. NO RIGHTS ARE RESERVED OR EXPRESS OR IMPLIED WARANTEE GIVEN. | | Ambient light 3V3 VEML7700-TR | +3V3 R6 10k SPI | REVISION | DESCRIPTION | DATE | APPROVED

DATE | PROJECT | * * APPROVALS * *

ENG: *

DSN: * | | PROJECT REVISION: Not in version control | DOCUMENT REVISION: Not in version control | DESIGN ITEM:

1

2

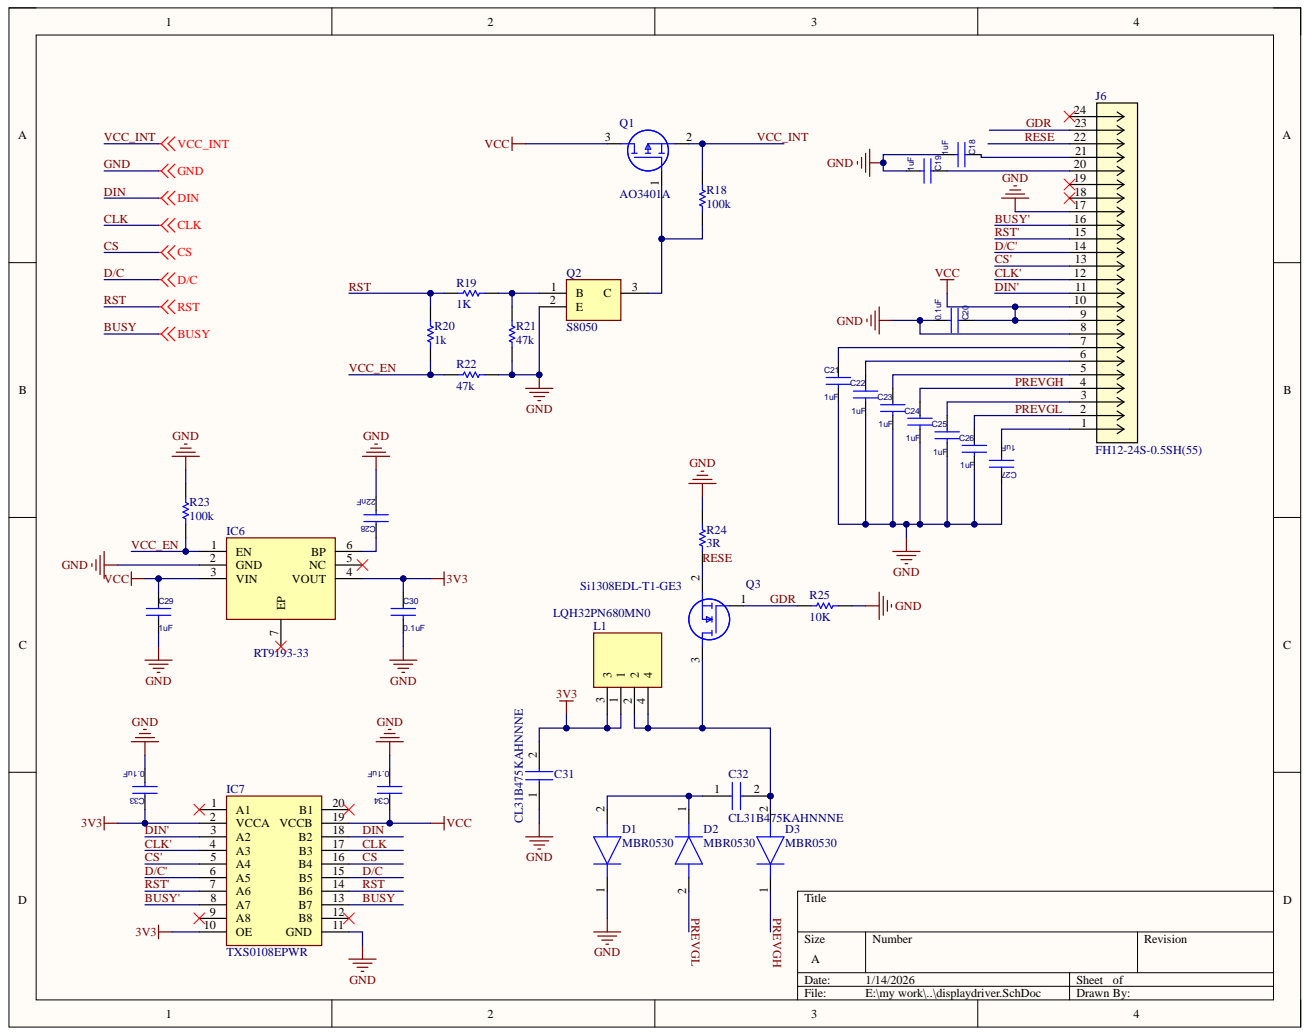
[picture p20: page 2]
