OxMarco/Quiesco/(list of files, drawings)

Other design files:
hardware/pcb-jst-sh/source/L-1K1W1007851A.PcbDoc
hardware/pcb-jst-sh/source/L-1K1W1007851A.SchDoc
hardware/sources/L-1K1W1007851A.PrjPcb
