OxMarco/Quiesco/hardware/pcb-minitek/source/L-1K1W1007851A.kicad_pcb

## KiCad design hardware/pcb-minitek/source/L-1K1W1007851A.kicad_pcb (2026-10-31)

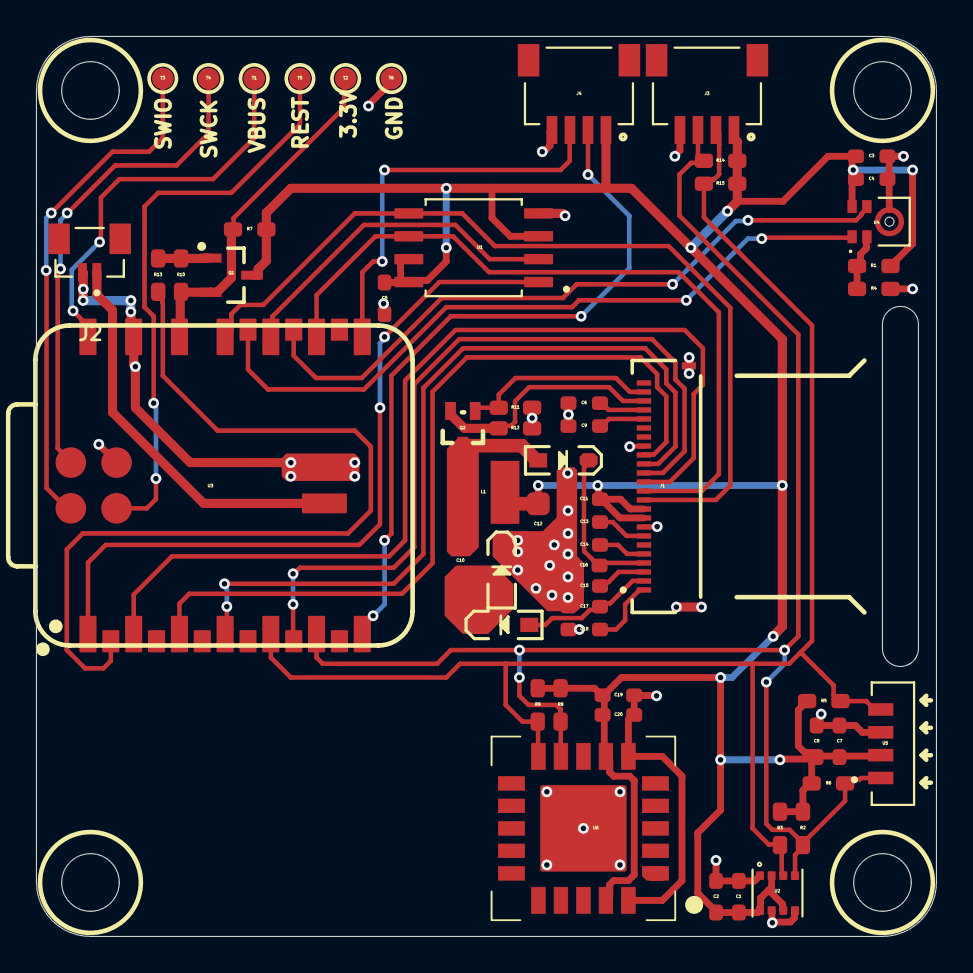
[picture p21: board L-1K1W1007851A.kicad_pcb from above]

Board: 2 copper layers, 50.0 x 50.0 mm, 57 parts (0 on the bottom side), 37 nets.

Parts:
C1, C3, C5, C7, C19: 0.1uF/50V; C 0603
C2, C4, C8, C20: 10uF/10V; C 0603
C6, C9, C11, C13, C14, C15, C16, C17, C18: 1uF/50V; C 0603
C10, C12: 4.7uF/50V; C 0805
D1, D2, D3: MBR0530; SOD-323
J1: HC-FPC-05-09-24RLTAG; GCT_FFC2B28-24-G
J2: 10144041-02011LF; AMPHENOL_10144041-02011LF
J3, J4: SM04B-GHS-TB(LF)(SN); JST_SM04B-SRSS-TB(LF)(SN)
L1: 10uH/1A; CD31
Q1: AO3401; SOT23-3N
Q2: SI1308EDL; SOT323
R1, R2, R3, R5, R6, R7, R8, R9: NC; R 0603
R4: 0R; R 0603
R10: 10K; R 0603
R11: 1M; R 0603
R12: 0.47R; R 0603
R13: 100R; R 0603
R14, R15: 4.7K; R 0603
T1, T2, T3, T4, T5, T6: PAD 1.2mm; TEST 1.2
U1: W25Q64JVSSIQ; SOIC127P790X216-8N
U2: BME280; PSON65P250X250X100-8N
U3: XIAO-nRF52840-Plus
U4: SPH0641LU4H-1; MIC_SPH0641LU4H-1
U5: VEML7700-TR; XDCR_VEML7700-TR
U6: SCD41-D-R1; SCD4x

Connections:
3V3ON: R13.2, U3.15
+3.3V: C1.2, C2.2, C3.2, C4.2, C5.2, C7.2, C8.2, C11.1, C12.2, C19.2, C20.2, J1.9, J1.10, J3.1, J4.1, L1.1, Q1.3, R1.1, R2.1, R3.1, R5.1, R6.1, R7.2, R8.1, R9.1, R14.1, R15.1, U1.3, U1.7, U1.8, U2.2, U2.6, U2.8, U4.5, U5.2, U6.7, U6.19
+3.3V_PS: Q1.2, R7.1, R10.1, T2.1, U3.12
BME_SCL: J3.3, R2.2, R6.2, R8.2, R14.2, U2.4, U3.6, U5.1, U6.9
BME_SDA: J3.2, R3.2, R5.2, R9.2, R15.2, U2.3, U3.5, U5.4, U6.10
C_RX: J4.3, U3.8
C_TX: J4.2, U3.7
ED_BUSY: J1.16, U3.3
ED_CS: J1.13, U3.2
ED_DC: J1.14, U3.19
ED_DI: J1.11, U1.5, U3.11
ED_RES: J1.15, U3.4
ED_SCLK: J1.12, U1.6, U3.9
GDR: J1.23, Q2.1, R11.1
GND: C1.1, C2.1, C3.1, C4.1, C5.1, C6.2, C7.1, C8.1, C9.2, C11.2, C12.1, C13.2, C14.2, C15.2, C16.1, C17.2, C18.2, C19.1, C20.1, D2.2, J1.8, J1.17, J1.S1, J1.S2, J2.2, J3.4, J4.4, R4.2, R11.2, R12.2, T6.1, U1.4, U2.1, U2.5, U2.7, U3.13, U3.27, U3.29, U4.3, U5.3, U6.6, U6.20, U6.21
NetC6_1: C6.1, J1.21
NetC9_1: C9.1, J1.20
NetC10_1: C10.1, D3.1, L1.2, Q2.3
NetC10_2: C10.2, D1.2, D2.1
NetC13_1: C13.1, J1.7
NetC14_1: C14.1, J1.5
NetC15_1: C15.1, J1.3
NetQ1_1: Q1.1, R10.2, R13.1
NetR1_2: R1.2, R4.1, U4.2
P0.02: U1.1, U3.1
P1.05: U3.22, U4.4
P1.07: U3.23, U4.1
P1.14: U1.2, U3.10
PREVGH: C16.2, D3.2, J1.4
PREVGL: C17.1, D1.1, J1.2
RESE: J1.22, Q2.2, R12.1
REST: T5.1, U3.26
SWDCLK: T4.1, U3.25
SWDIO: T3.1, U3.24
VBAT: J2.1, U3.28
VBUS: T1.1, U3.14
VCOM: C18.1, J1.1
