OxMarco/Quiesco/firmware/src/services/WallClock.h

// SPDX-License-Identifier: GPL-3.0-only
#pragma once

#include <stdint.h>

// Anchors the BLE-supplied Unix epoch to the monotonic clock. Purely RAM, and
// there is no RTC: the app re-syncs on connect. The one exception is a
// watchdog or lockup reset, when App re-anchors from the time of the last
// watchdog feed (ResetHistory::epochAtReset), which bounds the gap. After any
// other reset the epoch is lost, so a stale anchor never mis-stamps records.
class WallClock {
 public:
  void sync(uint64_t epochMs, uint64_t monotonicNowMs) {
    epochAtSyncMs_ = epochMs;
    monotonicAtSyncMs_ = monotonicNowMs;
    synced_ = epochMs != 0;
  }

  bool synced() const { return synced_; }

  // Wall-clock for any monotonic instant, before or after the sync point;
  // 0 when never synced.
  uint64_t epochMsAt(uint64_t monotonicMs) const {
    if (!synced_) {
      return 0;
    }
    if (monotonicMs >= monotonicAtSyncMs_) {
      return epochAtSyncMs_ + (monotonicMs - monotonicAtSyncMs_);
    }
    const uint64_t before = monotonicAtSyncMs_ - monotonicMs;
    return before < epochAtSyncMs_ ? epochAtSyncMs_ - before : 0;
  }

 private:
  uint64_t epochAtSyncMs_ = 0;
  uint64_t monotonicAtSyncMs_ = 0;
  bool synced_ = false;
};
