OxMarco/Quiesco/firmware/tests/host/test_main.cpp

// SPDX-License-Identifier: GPL-3.0-only
#include <cmath>
#include <string>
#include <vector>

#include "doctest.h"

#include "drivers/Bme280Compensation.h"
#include "drivers/Veml7700Lux.h"
#include "dsp/AcousticMetrics.h"
#include "model/Config.h"
#include "model/FaultStatus.h"
#include "model/Reading.h"
#include "services/SampleRecord.h"
#include "services/Scheduler.h"
#include "model/SleepWindow.h"
#include "parity/sleep_parity_vectors.h"
#include "ui/ComfortEvaluation.h"
#include "ui/LightTile.h"
#include "ui/SleepSchedule.h"
#include "ui/UiModel.h"

namespace {




TEST_CASE("config validation") {
  const Config defaults = defaultConfig();
  CHECK(isValidConfig(defaults));
  CHECK(defaults.displayScreen == DISPLAY_SCREEN_BENTO);
  CHECK(isValidMeasurementInterval(60));
  CHECK(isValidMeasurementInterval(300));
  CHECK(isValidMeasurementInterval(600));
  CHECK(isValidMeasurementInterval(1800));
  CHECK(!isValidMeasurementInterval(0));
  CHECK(!isValidMeasurementInterval(120));
  CHECK(!isValidMeasurementInterval(3600));

  CHECK(isValidDeviceName("Quiesco"));
  CHECK(isValidDeviceName("0123456789abcdef"));  // 16 bytes, the max
  CHECK(!isValidDeviceName(""));
  CHECK(!isValidDeviceName("0123456789abcdefg"));  // 17 bytes
  CHECK(!isValidDeviceName("bad\tname"));          // control byte

  CHECK(isValidCalibrationOffsets(-24.0f, 8.0f, -20.0f));
  CHECK(!isValidCalibrationOffsets(-25.0f, 0.0f, 0.0f));
  CHECK(!isValidCalibrationOffsets(0.0f, 8.5f, 0.0f));
  CHECK(!isValidCalibrationOffsets(0.0f, 0.0f, 20.5f));
  Config badName = defaults;
  badName.deviceName[0] = '\0';
  CHECK(!isValidConfig(badName));
  Config badOffset = defaults;
  badOffset.tempOffsetC = 99.0f;
  CHECK(!isValidConfig(badOffset));

  Config invalid = defaults;
  invalid.version++;
  CHECK(!isValidConfig(invalid));
  invalid = defaults;
  invalid.fullRefreshEveryCycles = 0;
  CHECK(!isValidConfig(invalid));

  CHECK(isValidDisplayScreen(DISPLAY_SCREEN_FACE));
  CHECK(isValidDisplayScreen(DISPLAY_SCREEN_LEDGER));
  CHECK(isValidDisplayScreen(DISPLAY_SCREEN_BENTO));
  CHECK(!isValidDisplayScreen(3));
  invalid = defaults;
  invalid.displayScreen = 3;
  CHECK(!isValidConfig(invalid));
}

TEST_CASE("immediate boot and deadline progression") {
  Scheduler scheduler;
  scheduler.begin(1250, 60);
  CHECK(scheduler.claimDue(1250));
  CHECK_EQ(uint64_t{61250}, scheduler.nextDeadlineMs());
  CHECK(!scheduler.claimDue(61249));
  CHECK(scheduler.claimDue(61250));
  CHECK_EQ(uint64_t{121250}, scheduler.nextDeadlineMs());
}

TEST_CASE("missed deadlines coalesce without drift") {
  Scheduler scheduler;
  scheduler.begin(1000, 60);
  CHECK(scheduler.claimDue(1000));
  CHECK(scheduler.claimDue(190000));
  CHECK_EQ(uint64_t{241000}, scheduler.nextDeadlineMs());
  CHECK(!scheduler.claimDue(190000));
}

TEST_CASE("interval change starts from now") {
  Scheduler scheduler;
  scheduler.begin(0, 300);
  CHECK(scheduler.claimDue(0));
  scheduler.changeInterval(45000, 60);
  CHECK_EQ(uint64_t{105000}, scheduler.nextDeadlineMs());
  CHECK(!scheduler.claimDue(104999));
  CHECK(scheduler.claimDue(105000));
  CHECK_EQ(uint32_t{60}, scheduler.intervalSeconds());
}

TEST_CASE("deadline crosses millis() rollover") {
  const uint64_t beforeRollover = (uint64_t{1} << 32) - 1000;
  Scheduler scheduler;
  scheduler.begin(beforeRollover, 60);
  CHECK(scheduler.claimDue(beforeRollover));
  CHECK_EQ(beforeRollover + 60000, scheduler.nextDeadlineMs());
  CHECK(scheduler.nextDeadlineMs() > (uint64_t{1} << 32));
}

TEST_CASE("fault counters recover and saturate") {
  DeviceFault fault;
  recordDeviceResult(fault, false, false, false);
  CHECK_EQ(uint16_t{1}, fault.consecutiveFailures);
  CHECK(!fault.present);

  recordDeviceResult(fault, true, true, false);
  CHECK_EQ(uint16_t{2}, fault.consecutiveFailures);
  CHECK(fault.present);
  CHECK(fault.timedOut);

  recordDeviceResult(fault, true, false, true);
  CHECK_EQ(uint16_t{0}, fault.consecutiveFailures);
  CHECK(!fault.timedOut);

  fault.consecutiveFailures = UINT16_MAX;
  recordDeviceResult(fault, true, false, false);
  CHECK_EQ(UINT16_MAX, fault.consecutiveFailures);
}

Reading comfortableReading() {
  Reading reading;
  reading.temperatureC = 18.0f;
  reading.humidityPct = 45.0f;
  reading.co2Ppm = 640.0f;
  reading.lux = 210.0f;
  reading.noiseDb = 38.0f;
  reading.batteryV = 3.9f;
  reading.valid = VALID_TEMPERATURE | VALID_HUMIDITY | VALID_CO2 |
                  VALID_LIGHT | VALID_NOISE | VALID_BATTERY;
  return reading;
}

TEST_CASE("comfort bands") {
  CHECK(Severity::kOk == bandSeverity(UiMetric::kCo2, 800.0f));
  CHECK(Severity::kWarn == bandSeverity(UiMetric::kCo2, 801.0f));
  CHECK(Severity::kWarn == bandSeverity(UiMetric::kCo2, 1000.0f));
  CHECK(Severity::kBad == bandSeverity(UiMetric::kCo2, 1001.0f));

  CHECK(Severity::kBad == bandSeverity(UiMetric::kTemperature, 13.0f));
  CHECK(Severity::kWarn == bandSeverity(UiMetric::kTemperature, 15.0f));
  CHECK(Severity::kOk == bandSeverity(UiMetric::kTemperature, 18.0f));
  CHECK(Severity::kWarn == bandSeverity(UiMetric::kTemperature, 22.0f));
  CHECK(Severity::kBad == bandSeverity(UiMetric::kTemperature, 25.0f));

  CHECK(Severity::kWarn == bandSeverity(UiMetric::kHumidity, 35.0f));
  CHECK(Severity::kOk == bandSeverity(UiMetric::kHumidity, 50.0f));
  CHECK(Severity::kBad == bandSeverity(UiMetric::kHumidity, 71.0f));

  CHECK(Severity::kOk == bandSeverity(UiMetric::kNoise, 45.0f));
  CHECK(Severity::kWarn == bandSeverity(UiMetric::kNoise, 46.0f));
  CHECK(Severity::kBad == bandSeverity(UiMetric::kNoise, 56.0f));

  // Light never leaves comfort: it must not drive the face.
  CHECK(Severity::kOk == bandSeverity(UiMetric::kLight, 100000.0f));
}

TEST_CASE("worst metric selection and priority") {
  Reading reading = comfortableReading();
  UiModel model = buildUiModel(reading, DISPLAY_SCREEN_FACE, TEMPERATURE_UNIT_CELSIUS, false);
  CHECK(model.faceSeverity == Severity::kOk);
  CHECK(model.screen == ScreenId::kFace);

  reading.co2Ppm = 1512.0f;
  model = buildUiModel(reading, DISPLAY_SCREEN_FACE, TEMPERATURE_UNIT_CELSIUS, false);
  CHECK(model.faceSeverity == Severity::kBad);
  CHECK(model.worstMetric == UiMetric::kCo2);
  CHECK(model.worstAbove);

  // Equal severity: CO2 outranks noise (enum order is the tie-break).
  reading.co2Ppm = 900.0f;
  reading.noiseDb = 50.0f;
  model = buildUiModel(reading, DISPLAY_SCREEN_FACE, TEMPERATURE_UNIT_CELSIUS, false);
  CHECK(model.faceSeverity == Severity::kWarn);
  CHECK(model.worstMetric == UiMetric::kCo2);

  // A worse metric wins regardless of order; an invalid one is ignored.
  reading.noiseDb = 80.0f;
  model = buildUiModel(reading, DISPLAY_SCREEN_FACE, TEMPERATURE_UNIT_CELSIUS, false);
  CHECK(model.worstMetric == UiMetric::kNoise);
  reading.valid &= ~VALID_NOISE;
  model = buildUiModel(reading, DISPLAY_SCREEN_FACE, TEMPERATURE_UNIT_CELSIUS, false);
  CHECK(model.worstMetric == UiMetric::kCo2);
}

TEST_CASE("screen selection and battery override") {
  const Reading reading = comfortableReading();
  CHECK(buildUiModel(reading, DISPLAY_SCREEN_LEDGER, TEMPERATURE_UNIT_CELSIUS, false).screen ==
        ScreenId::kLedger);
  CHECK(buildUiModel(reading, DISPLAY_SCREEN_BENTO, TEMPERATURE_UNIT_CELSIUS, false).screen ==
        ScreenId::kBento);
  CHECK(buildUiModel(reading, DISPLAY_SCREEN_BENTO, TEMPERATURE_UNIT_CELSIUS, true).screen ==
        ScreenId::kBattery);

  Reading lowBattery = reading;
  lowBattery.batteryV = 3.4f;
  CHECK(buildUiModel(lowBattery, DISPLAY_SCREEN_FACE, TEMPERATURE_UNIT_CELSIUS, false).screen ==
        ScreenId::kBattery);
  // Hysteresis: 3.55 V enters nothing, but leaves the battery screen only
  // once the cell is back above 3.6 V.
  lowBattery.batteryV = 3.55f;
  const UiModel calm = buildUiModel(lowBattery, DISPLAY_SCREEN_FACE, TEMPERATURE_UNIT_CELSIUS,
                                    false, JudgeMode::kSleep, false);
  CHECK(calm.screen == ScreenId::kFace);
  CHECK(!calm.batteryLow);
  const UiModel held = buildUiModel(lowBattery, DISPLAY_SCREEN_FACE, TEMPERATURE_UNIT_CELSIUS,
                                    false, JudgeMode::kSleep, true);
  CHECK(held.screen == ScreenId::kBattery);
  CHECK(held.batteryLow);
  lowBattery.batteryV = 3.65f;
  CHECK(buildUiModel(lowBattery, DISPLAY_SCREEN_FACE, TEMPERATURE_UNIT_CELSIUS, false,
                     JudgeMode::kSleep, true).screen == ScreenId::kFace);
  // Unknown battery voltage must not trap the UI on the battery screen.
  lowBattery.valid &= ~VALID_BATTERY;
  CHECK(buildUiModel(lowBattery, DISPLAY_SCREEN_FACE, TEMPERATURE_UNIT_CELSIUS, false).screen ==
        ScreenId::kFace);
}

// °F changes only the digits drawn: severity and the face's verdict are still
// judged on the rounded °C value, and switching units forces a redraw.
TEST_CASE("fahrenheit display") {
  Reading reading = comfortableReading();
  reading.temperatureC = 29.4f;  // 85 °F, above the 24 °C bad limit
  const uint8_t t = static_cast<uint8_t>(UiMetric::kTemperature);
  const UiModel c = buildUiModel(reading, DISPLAY_SCREEN_FACE,
                                 TEMPERATURE_UNIT_CELSIUS, false);
  const UiModel f = buildUiModel(reading, DISPLAY_SCREEN_FACE,
                                 TEMPERATURE_UNIT_FAHRENHEIT, false);
  CHECK_EQ(int32_t{29}, c.values[t]);
  CHECK_EQ(int32_t{85}, f.values[t]);
  CHECK((f.fahrenheit && !c.fahrenheit));
  CHECK(f.severities[t] == c.severities[t]);
  CHECK(f.faceSeverity == Severity::kBad);
  CHECK((f.worstMetric == UiMetric::kTemperature && f.worstAbove));
  CHECK(!hasSameRenderedContent(c, f));

  // Other metrics are untouched.
  const uint8_t h = static_cast<uint8_t>(UiMetric::kHumidity);
  CHECK_EQ(c.values[h], f.values[h]);
}

// The app's judge-mode tests, run against the firmware: every case of
// parity/sleep_parity_vectors.h is the app's own judgeMode (sleep.ts) swept
// over nine days in 15 s steps under a fixed UTC offset, covering bedtimes
// before and after midnight and the rounded 60 min lead.
TEST_CASE("judge mode parity with the app") {
  for (const SleepParity::Case& c : SleepParity::kCases) {
    CAPTURE(c.name);
    SleepWindow window = defaultSleepWindow();
    window.flags = SleepWindow::kFlagFollowApp;
    window.utcOffsetMinutes = c.offsetMin;
    window.bedMin = c.bed;
    window.wakeMin = c.wake;
    REQUIRE(isValidSleepWindow(window));
    uint32_t next = 0;
    uint8_t expected = 0;
    uint32_t mismatches = 0;
    for (uint32_t step = 0; step < SleepParity::kSteps; ++step) {
      if (next < c.count && c.changes[next].step == step) {
        expected = c.changes[next++].sleep;
      }
      const uint64_t epochMs =
          SleepParity::kStartMs + uint64_t{step} * SleepParity::kStepMs;
      const bool sleep =
          SleepSchedule::judgeMode(epochMs, window) == JudgeMode::kSleep;
      if (sleep != (expected == 1)) {
        if (mismatches++ == 0) {
          CAPTURE(step);
          CHECK_MESSAGE(false, "first mismatch with the app");
        }
      }
    }
    CHECK_EQ(uint32_t{0}, mismatches);
  }
}

TEST_CASE("judge mode around bedtime and wake") {
  SleepWindow window = defaultSleepWindow();  // 23:30-07:00
  window.flags = SleepWindow::kFlagFollowApp;
  // Thursday 2026-10-01, UTC.
  const uint64_t day = 1790812800000ULL;
  const uint64_t minute = 60000;
  auto at = [&](uint64_t ms) { return SleepSchedule::judgeMode(ms, window); };
  CHECK(at(day + 12 * 60 * minute) == JudgeMode::kDay);
  // The lead is rounded like the app's Math.round: 60.5 min before is day,
  // a second later is sleep.
  const uint64_t bed = day + (23 * 60 + 30) * minute;
  CHECK(at(bed - 60 * minute - 30000) == JudgeMode::kDay);
  CHECK(at(bed - 60 * minute - 29000) == JudgeMode::kSleep);
  CHECK(at(bed) == JudgeMode::kSleep);
  // Across midnight until wake, then day again.
  CHECK(at(day + 24 * 60 * minute + 3 * 60 * minute) == JudgeMode::kSleep);
  CHECK(at(day + 24 * 60 * minute + 7 * 60 * minute - 1) == JudgeMode::kSleep);
  CHECK(at(day + 24 * 60 * minute + 7 * 60 * minute) == JudgeMode::kDay);

  // A changed offset moves every boundary with it, as a daylight-saving
  // change does once the app rewrites the offset: 22:00 UTC is 23:00 at
  // UTC+60, inside the lead, and 21:00 at UTC-60.
  const uint64_t tenPm = day + 22 * 60 * minute;
  CHECK(at(tenPm) == JudgeMode::kDay);
  window.utcOffsetMinutes = 60;
  CHECK(at(tenPm) == JudgeMode::kSleep);
  window.utcOffsetMinutes = -60;
  CHECK(at(tenPm) == JudgeMode::kDay);
  // 06:30 UTC: still asleep at UTC+0, awake at UTC+60 (07:30 local).
  const uint64_t morning = day + 24 * 60 * minute + 6 * 60 * minute + 30 * minute;
  window.utcOffsetMinutes = 0;
  CHECK(at(morning) == JudgeMode::kSleep);
  window.utcOffsetMinutes = 60;
  CHECK(at(morning) == JudgeMode::kDay);

  // Friday and Saturday nights use the same window as every other night.
  window.utcOffsetMinutes = 0;
  const uint64_t friday = day + 24 * 60 * minute;
  CHECK(at(friday + (23 * 60 + 30) * minute) == JudgeMode::kSleep);
  CHECK(at(friday + (24 * 60 + 7 * 60 + 30) * minute) == JudgeMode::kDay);
}

TEST_CASE("judge mode for windows that run past noon") {
  SleepWindow window = defaultSleepWindow();
  window.flags = SleepWindow::kFlagFollowApp;
  const uint64_t day = 1790812800000ULL;  // Thursday 2026-10-01 00:00 UTC
  const uint64_t minute = 60000;
  auto at = [&](uint64_t hhmm) {
    return SleepSchedule::judgeMode(day + (hhmm / 100 * 60 + hhmm % 100) * minute, window);
  };
  window.bedMin = 4 * 60;  // a late wake: 04:00-12:30
  window.wakeMin = 12 * 60 + 30;
  CHECK(at(1159) == JudgeMode::kSleep);
  CHECK(at(1215) == JudgeMode::kSleep);
  CHECK(at(1230) == JudgeMode::kDay);
  window.bedMin = 8 * 60;  // a night shift: 08:00-16:00
  window.wakeMin = 16 * 60;
  CHECK(at(1300) == JudgeMode::kSleep);
  CHECK(at(1559) == JudgeMode::kSleep);
  CHECK(at(1600) == JudgeMode::kDay);
  window.bedMin = 23 * 60;  // the app's longest: 23:00-13:00
  window.wakeMin = 13 * 60;
  CHECK(at(1230) == JudgeMode::kSleep);
  CHECK(at(1300) == JudgeMode::kDay);
  window.bedMin = 11 * 60 + 45;  // bedtime just before noon: 11:45-19:00
  window.wakeMin = 19 * 60;
  CHECK(at(1201) == JudgeMode::kSleep);
  CHECK(at(1859) == JudgeMode::kSleep);
  CHECK(at(1900) == JudgeMode::kDay);
}

TEST_CASE("panel judge mode falls back to sleep bands") {
  SleepWindow window = defaultSleepWindow();
  const uint64_t noon = 1790812800000ULL + 12 * 3600000ULL;
  // Flag clear: sleep bands all day, as before the window existed.
  CHECK(SleepSchedule::panelJudgeMode(window, true, noon) == JudgeMode::kSleep);
  window.flags = SleepWindow::kFlagFollowApp;
  CHECK(SleepSchedule::panelJudgeMode(window, true, noon) == JudgeMode::kDay);
  // An unsynced clock cannot tell the hour.
  CHECK(SleepSchedule::panelJudgeMode(window, false, noon) == JudgeMode::kSleep);
  CHECK(SleepSchedule::panelJudgeMode(window, true, 0) == JudgeMode::kSleep);
}

TEST_CASE("day mode bands") {
  CHECK(isJudged(UiMetric::kCo2, JudgeMode::kDay));
  CHECK(isJudged(UiMetric::kNoise, JudgeMode::kDay));
  CHECK(!isJudged(UiMetric::kTemperature, JudgeMode::kDay));
  CHECK(!isJudged(UiMetric::kHumidity, JudgeMode::kDay));
  CHECK(!isJudged(UiMetric::kLight, JudgeMode::kDay));
  CHECK(!isJudged(UiMetric::kLight, JudgeMode::kSleep));
  // CO2 keeps its band.
  CHECK(Severity::kWarn == bandSeverity(UiMetric::kCo2, 801.0f, JudgeMode::kDay));
  CHECK(Severity::kBad == bandSeverity(UiMetric::kCo2, 1201.0f, JudgeMode::kDay));
  // Noise on the hearing band, the app's DAY_NOISE: warn above 70, bad above 85.
  CHECK(Severity::kOk == bandSeverity(UiMetric::kNoise, 70.0f, JudgeMode::kDay));
  CHECK(Severity::kWarn == bandSeverity(UiMetric::kNoise, 71.0f, JudgeMode::kDay));
  CHECK(Severity::kWarn == bandSeverity(UiMetric::kNoise, 85.0f, JudgeMode::kDay));
  CHECK(Severity::kBad == bandSeverity(UiMetric::kNoise, 86.0f, JudgeMode::kDay));
  // Temperature and humidity are never off by day.
  CHECK(Severity::kOk == bandSeverity(UiMetric::kTemperature, 35.0f, JudgeMode::kDay));
  CHECK(Severity::kOk == bandSeverity(UiMetric::kHumidity, 5.0f, JudgeMode::kDay));
}

TEST_CASE("day mode face and comparison") {
  Reading reading = comfortableReading();
  reading.temperatureC = 29.0f;  // bad on the sleep band
  reading.humidityPct = 80.0f;   // bad on the sleep band
  reading.noiseDb = 60.0f;       // bad at night, fine by day
  UiModel night = buildUiModel(reading, DISPLAY_SCREEN_FACE,
                               TEMPERATURE_UNIT_CELSIUS, false, JudgeMode::kSleep);
  CHECK(night.faceSeverity == Severity::kBad);
  CHECK(night.worstMetric == UiMetric::kTemperature);
  UiModel day = buildUiModel(reading, DISPLAY_SCREEN_FACE,
                             TEMPERATURE_UNIT_CELSIUS, false, JudgeMode::kDay);
  CHECK(day.mode == JudgeMode::kDay);
  CHECK(day.faceSeverity == Severity::kOk);  // shown, not judged
  const uint8_t t = static_cast<uint8_t>(UiMetric::kTemperature);
  CHECK_EQ(int32_t{29}, day.values[t]);
  CHECK(day.severities[t] == Severity::kOk);
  // A smiling face looks the same by day and night.
  reading = comfortableReading();
  CHECK(hasSameRenderedContent(
      buildUiModel(reading, DISPLAY_SCREEN_FACE, TEMPERATURE_UNIT_CELSIUS, false,
                   JudgeMode::kSleep),
      buildUiModel(reading, DISPLAY_SCREEN_FACE, TEMPERATURE_UNIT_CELSIUS, false,
                   JudgeMode::kDay)));

  // Loud by day: noise drives the face on the hearing band; the nudge words
  // differ by mode, so the same verdict in another mode is a redraw.
  reading.noiseDb = 90.0f;
  day = buildUiModel(reading, DISPLAY_SCREEN_FACE, TEMPERATURE_UNIT_CELSIUS,
                     false, JudgeMode::kDay);
  night = buildUiModel(reading, DISPLAY_SCREEN_FACE, TEMPERATURE_UNIT_CELSIUS,
                       false, JudgeMode::kSleep);
  CHECK(day.faceSeverity == Severity::kBad);
  CHECK(day.worstMetric == UiMetric::kNoise);
  CHECK(day.worstAbove);
  CHECK(night.faceSeverity == Severity::kBad);
  CHECK(!hasSameRenderedContent(day, night));
  reading.noiseDb = 75.0f;
  day = buildUiModel(reading, DISPLAY_SCREEN_FACE, TEMPERATURE_UNIT_CELSIUS,
                     false, JudgeMode::kDay);
  CHECK(day.faceSeverity == Severity::kWarn);

  // The ledger draws bands, which change with the mode; the bento only
  // inverts tiles, which the severities already capture.
  reading = comfortableReading();
  CHECK(!hasSameRenderedContent(
      buildUiModel(reading, DISPLAY_SCREEN_LEDGER, TEMPERATURE_UNIT_CELSIUS,
                   false, JudgeMode::kSleep),
      buildUiModel(reading, DISPLAY_SCREEN_LEDGER, TEMPERATURE_UNIT_CELSIUS,
                   false, JudgeMode::kDay)));
  CHECK(hasSameRenderedContent(
      buildUiModel(reading, DISPLAY_SCREEN_BENTO, TEMPERATURE_UNIT_CELSIUS,
                   false, JudgeMode::kSleep),
      buildUiModel(reading, DISPLAY_SCREEN_BENTO, TEMPERATURE_UNIT_CELSIUS,
                   false, JudgeMode::kDay)));
  reading.temperatureC = 29.0f;
  const UiModel bentoDay = buildUiModel(reading, DISPLAY_SCREEN_BENTO,
                                        TEMPERATURE_UNIT_CELSIUS, false,
                                        JudgeMode::kDay);
  CHECK(bentoDay.severities[t] == Severity::kOk);  // no inverted tile
}

// Covers hasSameRenderedContent, the comparison App actually gates panel
// refreshes on. It is deliberately per-screen: a metric that changed but is
// not drawn on the current screen must not cost a refresh.
TEST_CASE("UiModel skip comparison") {
  const Reading reading = comfortableReading();
  const UiModel a = buildUiModel(reading, DISPLAY_SCREEN_FACE, TEMPERATURE_UNIT_CELSIUS, false);
  CHECK(hasSameRenderedContent(
      a, buildUiModel(reading, DISPLAY_SCREEN_FACE, TEMPERATURE_UNIT_CELSIUS, false)));

  // A resting face draws no values, so a comfortable metric moving (even past
  // a rounding step) changes nothing on screen.
  Reading jitter = reading;
  jitter.temperatureC += 1.2f;
  CHECK(hasSameRenderedContent(
      a, buildUiModel(jitter, DISPLAY_SCREEN_FACE, TEMPERATURE_UNIT_CELSIUS, false)));

  // Leaving the comfort band does change the face, and the callout it draws
  // tracks the offending value.
  Reading hot = reading;
  hot.co2Ppm = 1512.0f;
  const UiModel bad = buildUiModel(hot, DISPLAY_SCREEN_FACE, TEMPERATURE_UNIT_CELSIUS, false);
  CHECK(!hasSameRenderedContent(a, bad));
  hot.co2Ppm = 1610.0f;
  CHECK(
      !hasSameRenderedContent(bad, buildUiModel(hot, DISPLAY_SCREEN_FACE, TEMPERATURE_UNIT_CELSIUS,
                                          false)));

  // The ledger draws every metric, so the same sub-band move does matter there.
  const UiModel ledger = buildUiModel(reading, DISPLAY_SCREEN_LEDGER, TEMPERATURE_UNIT_CELSIUS, false);
  CHECK(!hasSameRenderedContent(
      ledger, buildUiModel(jitter, DISPLAY_SCREEN_LEDGER, TEMPERATURE_UNIT_CELSIUS, false)));

  // Charging state is only drawn on the battery screen.
  Reading low = reading;
  low.batteryV = 3.4f;
  const UiModel battery = buildUiModel(low, DISPLAY_SCREEN_FACE, TEMPERATURE_UNIT_CELSIUS, false);
  CHECK(battery.screen == ScreenId::kBattery);
  CHECK(!hasSameRenderedContent(
      battery, buildUiModel(low, DISPLAY_SCREEN_FACE, TEMPERATURE_UNIT_CELSIUS, true)));

  // The pairing code redraws only when the code changes, and never compares
  // equal to a reading screen.
  const UiModel pairing = buildPairingModel(482913);
  CHECK(pairing.screen == ScreenId::kPairing);
  CHECK(hasSameRenderedContent(pairing, buildPairingModel(482913)));
  CHECK(!hasSameRenderedContent(pairing, buildPairingModel(482914)));
  CHECK(!hasSameRenderedContent(pairing, battery));
}

std::vector<int16_t> squareWave(int16_t amplitude, int16_t dcOffset,
                                uint16_t count) {
  std::vector<int16_t> samples(count);
  for (uint16_t i = 0; i < count; ++i) {
    samples[i] =
        static_cast<int16_t>(dcOffset + (i % 2 == 0 ? amplitude : -amplitude));
  }
  return samples;
}

// A-weighted level of a pure tone relative to its unweighted level, dB. The
// mic's DC offset rides along, as it does on hardware.
float aWeightingGainDb(float frequencyHz) {
  constexpr uint16_t kCount = 1024;
  constexpr float kPi = 3.14159265358979f;
  AcousticMetrics metrics;
  metrics.reset();
  std::vector<int16_t> buffer(kCount);
  uint32_t n = 0;
  for (uint8_t b = 0; b < 12; ++b) {
    for (uint16_t i = 0; i < kCount; ++i, ++n) {
      const float phase = 2.0f * kPi * frequencyHz *
                          static_cast<float>(n) / AcousticMetrics::kSampleRateHz;
      buffer[i] = static_cast<int16_t>(800.0f + 10000.0f * std::sin(phase));
    }
    metrics.addBuffer(buffer.data(), kCount);
  }
  return 20.0f * std::log10(metrics.weightedRms() / (10000.0f / std::sqrt(2.0f)));
}

TEST_CASE("A-weighting") {
  // IEC 61672 A-weighting, dB: the filter must hold these within 0.3 dB
  // (tones near the band edges within 0.5 dB).
  const struct {
    float hz;
    float expectedDb;
    float toleranceDb;
  } points[] = {
      {31.5f, -39.5f, 0.5f}, {63.0f, -26.2f, 0.3f}, {100.0f, -19.1f, 0.3f},
      {250.0f, -8.6f, 0.3f}, {500.0f, -3.2f, 0.3f}, {1000.0f, 0.0f, 0.3f},
      {2000.0f, 1.2f, 0.3f}, {4000.0f, 1.0f, 0.3f}, {6300.0f, -0.1f, 0.5f},
  };
  for (const auto& point : points) {
    const float got = aWeightingGainDb(point.hz);
    CAPTURE(point.hz);
    CAPTURE(point.expectedDb);
    CAPTURE(got);
    CHECK(std::fabs(got - point.expectedDb) <= point.toleranceDb);
  }
}

TEST_CASE("acoustic metrics") {
  constexpr uint16_t kCount = 1024;
  AcousticMetrics metrics;
  metrics.reset();
  CHECK(!metrics.valid());  // empty window is never audio

  // Pure DC reads as silence: the mean is removed per buffer.
  const auto dcOnly = squareWave(0, 1000, kCount);
  metrics.addBuffer(dcOnly.data(), kCount);
  CHECK(metrics.rms() < 1.0f);
  CHECK_EQ(int32_t{1000}, metrics.dcMean());
  CHECK(!metrics.valid());

  // A +/-1000 square is RMS 1000 and peak 1000, DC offset notwithstanding.
  metrics.reset();
  const auto square = squareWave(1000, 200, kCount);
  metrics.addBuffer(square.data(), kCount);
  CHECK(std::fabs(metrics.rms() - 1000.0f) < 1.0f);
  CHECK_EQ(int32_t{1000}, metrics.peak());
  CHECK_EQ(uint32_t{0}, metrics.clipped());
  CHECK(metrics.valid());

  // The stopped-clock signature -- samples pinned at the rail -- is invalid
  // even though its RMS is huge.
  metrics.reset();
  const auto pinned = squareWave(32200, 0, kCount);
  metrics.addBuffer(pinned.data(), kCount);
  CHECK_EQ(uint32_t{kCount}, metrics.clipped());
  CHECK(!metrics.valid());

  // Multi-buffer accumulation is DC-shift independent per buffer.
  metrics.reset();
  const auto shifted = squareWave(1000, -300, kCount);
  metrics.addBuffer(square.data(), kCount);
  metrics.addBuffer(shifted.data(), kCount);
  CHECK_EQ(uint16_t{2}, metrics.buffers());
  CHECK(std::fabs(metrics.rms() - 1000.0f) < 1.0f);

  // Half-scale square at +8 dB PDM gain: -6 dBFS - 8 + 120 ~ 106 dB SPL.
  metrics.reset();
  const auto halfScale = squareWave(16384, 0, kCount);
  metrics.addBuffer(halfScale.data(), kCount);
  CHECK(std::fabs(metrics.dbSpl(8.0f) - 106.0f) < 0.1f);
  // Quieter signal, lower level.
  AcousticMetrics quiet;
  quiet.reset();
  quiet.addBuffer(square.data(), kCount);
  CHECK(quiet.dbSpl(8.0f) < metrics.dbSpl(8.0f));
}

TEST_CASE("sample record codec") {
  SampleRecord record = {};
  record.sequence = 42;
  record.validFlags = 0x7F;
  record.monotonicMs = 1234567;
  record.temperatureC = 23.5f;
  record.co2Ppm = 640.0f;
  sealSampleRecord(record);
  CHECK(isValidSampleRecord(record));

  // Any corruption must fail the CRC; sequence sentinels are invalid even
  // with a matching CRC (0xFFFFFFFF is erased flash, 0 a torn write).
  SampleRecord corrupted = record;
  corrupted.co2Ppm = 641.0f;
  CHECK(!isValidSampleRecord(corrupted));
  corrupted = record;
  corrupted.sequence = 0;
  sealSampleRecord(corrupted);
  CHECK(!isValidSampleRecord(corrupted));
  corrupted.sequence = SampleRecord::kInvalidSequenceErased;
  sealSampleRecord(corrupted);
  CHECK(!isValidSampleRecord(corrupted));

  // An erased slot (all 0xFF) must never scan as a record.
  SampleRecord erased;
  unsigned char* bytes = reinterpret_cast<unsigned char*>(&erased);
  for (unsigned i = 0; i < sizeof erased; i++) bytes[i] = 0xFF;
  CHECK(!isValidSampleRecord(erased));

  // CRC-16/CCITT reference value ("123456789" -> 0x29B1).
  CHECK_EQ(uint16_t{0x29B1},
           crc16Ccitt(reinterpret_cast<const uint8_t*>("123456789"), 9));
}

TEST_CASE("battery percent from volts") {
  CHECK_EQ(0u, unsigned{batteryPercentFromVolts(3.0f)});
  CHECK_EQ(0u, unsigned{batteryPercentFromVolts(3.3f)});
  CHECK_EQ(5u, unsigned{batteryPercentFromVolts(3.5f)});
  CHECK_EQ(50u, unsigned{batteryPercentFromVolts(3.8f)});
  CHECK_EQ(100u, unsigned{batteryPercentFromVolts(4.2f)});
  CHECK_EQ(100u, unsigned{batteryPercentFromVolts(4.5f)});
  CHECK(batteryPercentFromVolts(3.75f) < batteryPercentFromVolts(3.85f));
}

}  // namespace


TEST_CASE("BME280 compensation and failed reads") {
  // Bosch's worked example (BMP280 datasheet §8.1, the same T and P formulas).
  Bme280::Calibration c = {};
  c.t1 = 27504; c.t2 = 26435; c.t3 = -1000;
  c.p1 = 36477; c.p2 = -10685; c.p3 = 3024; c.p4 = 2855; c.p5 = 140;
  c.p6 = -7; c.p7 = 15500; c.p8 = -14600; c.p9 = 6000;
  c.h1 = 75; c.h2 = 362; c.h3 = 0; c.h4 = 313; c.h5 = 50; c.h6 = 30;
  CHECK(Bme280::plausible(c));
  const uint8_t burst[8] = {0x65, 0x5A, 0xC0, 0x7E, 0xED, 0x00, 0x6C, 0x00};
  const Bme280::Raw raw = Bme280::decodeBurst(burst);
  CHECK_EQ(415148, raw.pressure);
  CHECK_EQ(519888, raw.temperature);
  CHECK_EQ(0x6C00, raw.humidity);
  const Bme280::Measurement m = Bme280::compensate(c, raw);
  CHECK(m.temperatureC == doctest::Approx(25.08f));
  CHECK(m.pressurePa == doctest::Approx(100653.27f).epsilon(0.0005));
  CHECK(Bme280::validPressurePa(m.pressurePa));
  CHECK(std::isfinite(m.humidityPct));
  CHECK((m.humidityPct >= 0.0f && m.humidityPct <= 100.0f));

  // Humidity is clamped to the sensor's 0-100 %.
  CHECK_EQ(100.0f, Bme280::humidityPct(c, Bme280::temperatureFine(c, raw.temperature), 0xFFFF));
  CHECK_EQ(0.0f, Bme280::humidityPct(c, Bme280::temperatureFine(c, raw.temperature), 0));

  // Registers still at their reset values were not measured.
  Bme280::Raw skipped = raw;
  skipped.humidity = Bme280::kSkipped16Bit;
  skipped.pressure = Bme280::kSkipped20Bit;
  Bme280::Measurement partial = Bme280::compensate(c, skipped);
  CHECK(std::isfinite(partial.temperatureC));
  CHECK(std::isnan(partial.humidityPct));
  CHECK(std::isnan(partial.pressurePa));
  skipped.temperature = Bme280::kSkipped20Bit;
  partial = Bme280::compensate(c, skipped);
  CHECK(std::isnan(partial.temperatureC));
  CHECK(std::isnan(partial.humidityPct));
  CHECK(std::isnan(partial.pressurePa));

  // A pressure decoded from a failed transfer (0xF7 echoed) is rejected.
  const uint8_t echoed[8] = {0xF7, 0xF7, 0xF7, 0x7E, 0xED, 0x00, 0x6C, 0x00};
  const float bogus = Bme280::compensate(c, Bme280::decodeBurst(echoed)).pressurePa;
  CHECK_FALSE(Bme280::validPressurePa(bogus));
  CHECK_FALSE(Bme280::validPressurePa(NAN));
  CHECK_FALSE(Bme280::validPressurePa(29999.0f));
  CHECK(Bme280::validPressurePa(30000.0f));
  CHECK(Bme280::validPressurePa(110000.0f));
  CHECK_FALSE(Bme280::validPressurePa(110001.0f));

  // A calibration read from a silent bus.
  Bme280::Calibration blank = {};
  CHECK_FALSE(Bme280::plausible(blank));
  // P1 = 0 would divide by zero: NaN, not a crash or 0 Pa.
  Bme280::Calibration noP1 = c;
  noP1.p1 = 0;
  CHECK(std::isnan(Bme280::pressurePa(noP1, 128000, raw.pressure)));
}

TEST_CASE("VEML7700 lux conversion over the whole range") {
  using namespace Veml7700Lux;
  const float bright = resolutionLux(0.125f, 25.0f);
  CHECK(bright == doctest::Approx(2.1504f));
  CHECK(resolutionLux(2.0f, 400.0f) == doctest::Approx(0.0084f));
  // The correction raises readings and never lowers them below the raw lux.
  float previous = 0.0f;
  for (uint32_t counts = 0; counts <= 65535; counts += 1) {
    const float raw = counts * bright;
    const float lux = correctedLux(raw);
    CHECK(validLux(lux));
    CHECK(lux >= previous);  // monotonic: brighter never reads darker
    previous = lux;
    if (counts == 0) CHECK_EQ(0.0f, lux);
  }
  // Direct sun (raw ~30 klx) used to come out at 337 klx and be dropped.
  CHECK_EQ(kMaximumLux, correctedLux(30000.0f));
  CHECK(validLux(correctedLux(30000.0f)));
  // Indoor light is corrected by a few percent.
  CHECK(correctedLux(500.0f) == doctest::Approx(520.39f).epsilon(0.001));
  CHECK(saturated(65535));
  CHECK(saturated(kSaturatedCounts));
  CHECK_FALSE(saturated(kSaturatedCounts - 1));
  CHECK_FALSE(validLux(NAN));
  CHECK_FALSE(validLux(-0.1f));
  CHECK_FALSE(validLux(kMaximumLux + 1.0f));
}

TEST_CASE("comfort band edges match the app exactly") {
  struct Edge { UiMetric metric; float value; Severity sleep; };
  // At an edge the milder verdict holds, as in the app's references.ts:
  // bad is < warnLo or > warnHi, warn is < okLo or > okHi.
  const Edge edges[] = {
      {UiMetric::kTemperature, 13.0f, Severity::kBad},
      {UiMetric::kTemperature, 14.0f, Severity::kWarn},
      {UiMetric::kTemperature, 15.0f, Severity::kWarn},
      {UiMetric::kTemperature, 16.0f, Severity::kOk},
      {UiMetric::kTemperature, 20.0f, Severity::kOk},
      {UiMetric::kTemperature, 21.0f, Severity::kWarn},
      {UiMetric::kTemperature, 24.0f, Severity::kWarn},
      {UiMetric::kTemperature, 25.0f, Severity::kBad},
      {UiMetric::kHumidity, 29.0f, Severity::kBad},
      {UiMetric::kHumidity, 30.0f, Severity::kWarn},
      {UiMetric::kHumidity, 39.0f, Severity::kWarn},
      {UiMetric::kHumidity, 40.0f, Severity::kOk},
      {UiMetric::kHumidity, 60.0f, Severity::kOk},
      {UiMetric::kHumidity, 61.0f, Severity::kWarn},
      {UiMetric::kHumidity, 70.0f, Severity::kWarn},
      {UiMetric::kHumidity, 71.0f, Severity::kBad},
      {UiMetric::kHumidity, 0.0f, Severity::kBad},
      {UiMetric::kHumidity, 100.0f, Severity::kBad},
      {UiMetric::kNoise, 55.0f, Severity::kWarn},
      {UiMetric::kNoise, -10.0f, Severity::kOk},
      {UiMetric::kCo2, 0.0f, Severity::kOk},
      {UiMetric::kCo2, 40000.0f, Severity::kBad},
      {UiMetric::kTemperature, -40.0f, Severity::kBad},
      {UiMetric::kTemperature, 85.0f, Severity::kBad},
  };
  for (const Edge& edge : edges) {
    CAPTURE(static_cast<int>(edge.metric));
    CAPTURE(edge.value);
    CHECK(edge.sleep == bandSeverity(edge.metric, edge.value, JudgeMode::kSleep));
  }
  // By day: noise on hearing limits, temperature and humidity not judged.
  CHECK(Severity::kOk == bandSeverity(UiMetric::kNoise, 70.0f, JudgeMode::kDay));
  CHECK(Severity::kWarn == bandSeverity(UiMetric::kNoise, 71.0f, JudgeMode::kDay));
  CHECK(Severity::kWarn == bandSeverity(UiMetric::kNoise, 85.0f, JudgeMode::kDay));
  CHECK(Severity::kBad == bandSeverity(UiMetric::kNoise, 86.0f, JudgeMode::kDay));
  CHECK(Severity::kOk == bandSeverity(UiMetric::kTemperature, 35.0f, JudgeMode::kDay));
  CHECK(Severity::kOk == bandSeverity(UiMetric::kHumidity, 90.0f, JudgeMode::kDay));
  CHECK(Severity::kBad == bandSeverity(UiMetric::kCo2, 1001.0f, JudgeMode::kDay));
}

TEST_CASE("acoustic metrics at the extremes") {
  constexpr uint16_t kCount = 1000;
  AcousticMetrics metrics;

  // A dead microphone (all zeros): not audio, and the level stays finite.
  metrics.reset();
  const std::vector<int16_t> zeros(kCount, 0);
  for (int i = 0; i < 8; ++i) metrics.addBuffer(zeros.data(), kCount);
  CHECK_FALSE(metrics.valid());
  CHECK(std::isfinite(metrics.dbA(8.0f)));
  CHECK(std::isfinite(metrics.dbSpl(8.0f)));
  CHECK_EQ(int32_t{0}, metrics.peak());

  // Full scale both ways: no overflow in peak or the sums.
  metrics.reset();
  std::vector<int16_t> rails(kCount);
  for (uint16_t i = 0; i < kCount; ++i) rails[i] = i % 2 ? -32768 : 32767;
  for (int i = 0; i < 200; ++i) metrics.addBuffer(rails.data(), kCount);
  CHECK_EQ(int32_t{32768}, metrics.peak());
  CHECK_EQ(uint32_t{200 * kCount}, metrics.clipped());
  CHECK_FALSE(metrics.valid());
  CHECK(std::isfinite(metrics.dbA(8.0f)));
  CHECK(metrics.rms() == doctest::Approx(32767.5f).epsilon(0.001));

  // Up to 10 % of samples at the rail is still audio (a door slam); more is
  // the stopped-clock signature.
  auto withClipped = [&](uint16_t clipped) {
    std::vector<int16_t> samples = squareWave(1000, 0, kCount);
    for (uint16_t i = 0; i < clipped; ++i) samples[i] = i % 2 ? -32767 : 32767;
    AcousticMetrics m;
    m.reset();
    m.addBuffer(samples.data(), kCount);
    return m;
  };
  CHECK(withClipped(kCount / 10).valid());
  CHECK_FALSE(withClipped(kCount / 10 + 1).valid());
  CHECK_EQ(uint32_t{kCount / 10}, withClipped(kCount / 10).clipped());
}

TEST_CASE("light tile text fits every reading") {
  auto text = [](long lux) {
    char out[20];
    LightTile::format(lux, out, sizeof out);
    return std::string(out);
  };
  CHECK_EQ(std::string("0 lx"), text(0));
  CHECK_EQ(std::string("999 lx"), text(999));
  CHECK_EQ(std::string("1k lx"), text(1000));
  CHECK_EQ(std::string("1k lx"), text(1499));
  CHECK_EQ(std::string("2k lx"), text(1500));
  CHECK_EQ(std::string("99k lx"), text(99499));
  // 99.5 klx rounds to 100k, which drops the unit to fit the cell.
  CHECK_EQ(std::string("100k"), text(99500));
  CHECK_EQ(std::string("120k"), text(120000));
  CHECK_EQ(std::string("0 lx"), text(-1));
}
