OxMarco/Quiesco/(commit log)

2026-09-30 firmware fixes
    [BOM-old.xlsx, L-1K1W1007851A_CASE.STEP, PCB Manufacturing Process Specification.xlsx, bom-new.xlsx]
2026-10-07 app: get 1.0.0 ready for the stores
    Store readiness
    - About card with version, privacy policy, support email and a
    not-a-medical-device line; demo data available in release builds so
    App Review can use the app without a unit
    - eas.json (development, preview, production with remote build
    numbers), ITSAppUsesNonExemptEncryption false, build number 1,
    SDK-matched Expo packages, expo-application and expo-mail-composer
    - Release builds no longer log; key material is redacted even in dev
    Bluetooth and data
    - Single-flight connect, reconnect, sync and scan; reconnect from
    needsUsb/incompatible and on foreground; listener leaks fixed
    - Log sync checks the packet counter and re-requests fr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
2026-10-07 firmware: 1.0.0, paced log stream, sleep window and log erase
    - VERSION and DIS hardware revision 1.0.0
    - Pace log notifications 30 ms apart: ArduinoBLE reports every notify
    as sent and dropped ~45 % of a download on air; 0 lost since, at
    ~99 records/s
    - Sleep window characteristic 0012 (capability 14): with it on and the
    clock synced, the panel judges like the app (sleep bands from an hour
    before bed until wake; by day only CO2 and noise on 70/85 dB(A)
    hearing bands), with host parity tests against the app's sleep.ts
    - Log erase command, 000D opcode 2 (capability 13), refused unless the
    newest record is at or below the given sequence
    - scripts/ble-test.py: on-air test suite from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
    [App.cpp, App.h, BleCodec.cpp, BleCodec.h, BleConfig.cpp, BleConfig.h, ComfortEvaluation.cpp, ComfortEvaluation.h]
2026-10-07 landing: privacy policy page and footer links
    /privacy states that the app collects nothing on its own and describes
    the optional diagnostic report; the footer links it and the support
    email. Base layout takes a per-page title and description.
2026-10-07 ci: deploy the landing page from master
    The repository's branch is master; the trigger named main, so pushes
    never deployed.
2026-10-07 docs(workplan): refresh status and hand-off notes
    Where-things-stand reflects the on-air results; the session log ends
    with the open items in order, starting with the private repository
    blocking the landing site and the privacy page.
2026-10-07 firmware: USB drive updates from the app; drop the workplan
    The app's Unit > Update firmware restarts the unit into the XIAO
    bootloader's XIAO-BOOT drive (device control opcode 4, capability bit
    16, USB power only); copying the build's new quiesco-X.Y.Z.uf2 onto it
    flashes the firmware and keeps config, phone keys and the log. Tested
    on the bench unit: 1.0.0 -> 1.0.1 -> 1.0.0 from a Mac.
    BLE OTA (opcode 3, bit 15) is kept but compiled out (QUIESCO_BLE_OTA):
    the bootloader (0.9.2-29) accepts the update but never finishes the
    erase. PROTOCOL.md §9.3 records the findings.
    Also: host test for log resume after the ring wraps, AGENT.md and a
    README "Upgrade firmware" section, and WORKPLAN.md re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
2026-10-07 sync: stop full re-downloads and the 12 s wait per batch
    Right after boot the unit reported newest sequence 0 until its first
    measurement mounted the log. The app read that as a replaced log, reset
    its cursor and downloaded everything again, with a progress estimate of
    "1 reading" that the count then ran past.
    Firmware: mount the log while settings load and publish status as soon
    as BLE starts. A sync with no measurement due now powers only the bus
    and streams at once, so a long download's batches and lost-packet
    retries no longer cost a full measurement and a panel redraw each
    (first packet 12.4 s -> 0.5 s; whole 10,837-record bench log in 121 s,
    no gaps).
    App: a newest of 0 is no evidenc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
    [App.cpp, App.h, test_runtime.cpp]
2026-10-08 test: sync against a simulated unit; CI for app and firmware
    sync.test.ts drives the real syncLog() against a fake unit that speaks
    PROTOCOL.md §7 byte for byte, as old or current firmware, with lost
    packets, stalls, wrapped and replaced logs. Every test checks nothing is
    saved twice, the cursor, and that progress never passes its estimate.
    With the pre-cd6b8b8 app code the after-reboot test fails.
    It found a second bug: a stream the unit ends without END (its 10 s
    stall, a flash error) finished the sync as done with part of the log.
    runSync now asks again from the first record it lacks, as after a lost
    packet.
    check.yml runs tsc, lint and jest for the app, and make check, the host
    tests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
2026-10-08 firmware: host tests on Linux CI (GCC, system Mbed TLS)
    GCC flags a possible truncation of the unit name's serial suffix that
    clang does not; cap the base so the suffix always fits. Skip -isystem
    and -L for a system Mbed TLS (MBEDTLS_PREFIX=/usr), which broke
    libstdc++'s include_next.
    [UnitIdentity.cpp]
2026-10-09 landing: graphics over prose; drop Kickstarter; untrack old landing
    The page carried about 650 words of body copy around one interactive
    graphic. Each section now leads with a picture and keeps the detail one
    tap away:
    - Hero: icon chips replace the four pillar sentences, and the unit walks
    through the example rooms while it is on screen.
    - Measures: five cards where a reading drifts out of its band and the fix
    lights up; the research sits behind "Why this range".
    - App: the sample night's CO2 line draws itself, with the door, 1,000 ppm
    and window markers, then the verdict. Three small graphics replace the
    paragraphs.
    - Open source: an animated sampling pipeline and component tiles;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
2026-10-09 docs: refer to master, not main, in the landing README and check workflow
2026-10-10 compliance: XIAO nRF52840 Plus pack for the CE test lab
    Seeed's datasheets and RED/FCC/RoHS/TELEC/UKCA certificates for the module,
    links to the public FCC RF test reports, a statement that the module, antenna
    and RF settings are unchanged, and the product's EMC-relevant clocks.
2026-10-12 app: single sleep window, first-run setup, store review prompt
    - Sleep window: one window for every night, matching firmware; bytes
    8-11 written as the reserved FF FF FF FF
    - First run continues from pairing to the sleep window (setup=1)
    - Ask for an App Store / Play rating after a successful sync, at least
    5 nights and 3 days after install, at most every 120 days
    (expo-store-review; rules in ble/review-prompt.ts, unit-tested)
    - Low-battery threshold shared with the panel (LOW_BATTERY_V = 3.5 V)
    - Screen layout updates across today, nights, unit, metric and why
2026-10-12 docs: 400 mAh 453035 battery; roadmap item for multi-unit app
2026-10-12 firmware: RF test firmware for the compliance lab
    smoke/rftest drives the nRF52840 RADIO directly, with no BLE stack, so
    the lab can hold one channel: modulated TX (BLE 1M, PRBS9, back to
    back) or an unmodulated carrier at 2402/2440/2480 MHz, +8 dBm or 0 dBm.
    Key `a` keeps the host busy (e-ink refreshes, flash and I2C traffic) for
    the KDB 996369 check; `u` restarts as XIAO-BOOT. Controlled over USB
    serial; it keeps transmitting on battery once unplugged. Built by make
    smoke; never shipped. compliance/README.md §5 is the lab's guide.
2026-10-12 docs: bring every README and spec in line with the code
    - Status: BLE verified on air from iPhone and Mac (2026-10-07/08),
    Android untested; ArduinoBLE and GxEPD2 are production in SOFTWARE.md
    and dependencies.lock
    - The app's third tab is Settings (firmware update steps, app layout);
    the demo button is "Try it with demo data" and works in release builds
    - PROTOCOL.md: lost-packet rule in §7.4 (cited by App.h but missing),
    capabilities example 0x17FFF, ENROL conditions, END after a START at 0,
    sleep-window bytes 8-11 honest about rejected weekend times, test name
    - SOFTWARE.md: protocol 6, device control opcode 4, paced log stream,
    VEML7700 auto-ranging and 5 s timeout, trace ri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
2026-10-12 app: several units per phone; open-source licences screen
    Several units:
    - One shown unit drives every tab. With two or more, the Room title is
    the unit's name and opens a switcher (each unit's room verdict and
    sync state); Nights gets a unit chip. One unit looks as before.
    - Settings lists the units; each opens its own page (units/[serial])
    with what was the Device section plus its sleep window. "Forget this
    phone" becomes "Remove from this phone".
    - Sleep window, panel-follows-sleep and erase-after-sync are kept per
    unit. A new unit copies the shown one's window and panel choice, never
    the log erase. The old phone-wide settings move to the unit already on
    the phone; the shown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
2026-10-12 One set of sleep comfort bands for the panel, app and site
    The panel used office-style bands (20–26 °C, 30–60 %, 55 dB) while the
    app's references and the landing page used sleep research. All now use
    the sleep set: CO2 800/1000 ppm, 16–20 °C, 40–60 %, 45/55 dB(A). Day
    mode is unchanged and the panel still never judges light. A test keeps
    comfort.ts and references.ts in agreement.
    The landing page also credits temperature and humidity to the BME280,
    as on the schematic, and quotes the real sampling intervals.
2026-10-12 deps: force patched transitive packages
    npm overrides pin shell-quote 1.11+, source-map-js 1.2.2+,
    postcss-selector-parser 7.1.6+ and uuid 11.1.1+ (app) and source-map-js
    1.2.2+ (landing), closing six Dependabot alerts. decode-uri-component
    stays at 0.2.2: 0.5.0 is ESM-only and query-string 7 requires it.
2026-10-16 Add the v2 case under test and link the Hackaday project page
    The v2 shell reworks the side vent, adds a second vent for cross-flow and
    replaces the light-sensor insert pocket with an open hole. It stays marked
    "in test" in hardware/README.md; v1 remains the default. The light-sensor
    notes now say "case opening" to cover both versions.
    The README badge and the site's Hackaday and campaign links now point at
    the project page instead of the profile.
2026-10-17 Ship-readiness pass: firmware fixes, edge-case tests and CI checks
    Firmware fixes, each with a host test that fails without it:
    - BME280: stop a ~205 B heap leak per measurement (Adafruit's
    I2CDevice::begin() re-began Wire, leaking an mbed::I2C), the likely
    cause of the watchdog resets after 37-51 h on the soak bench; checked
    flat on the unit over 40 cycles. Source policy now allows one Wire.begin.
    - FlashDB TSDB: power cut before the first record in a sector restarted
    sequences or failed every mount; an erase cut short after a wrap
    skipped most of the history; a read error at mount mounted with
    sequence 0 and read uninitialised sector state.
    - BLE: a rename advertised a dangling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
2026-10-17 app: Device tab with battery estimates for the measurement interval
    The shown unit's settings move to their own tab between Nights and
    Settings. "Measure every" offers 1, 5 and 10 min, each with an estimated
    battery life from a datasheet power model (not yet measured); a unit
    already on 30 min keeps that option. The sleep window row is dropped,
    as the home screen already sets it.
2026-10-17 Point the firmware update guide at the Device tab
2026-10-31 hardware: per-board folders, Minitek battery variant and MJF nylon case
    Split the board files into pcb-jst-sh/ and pcb-minitek/ (the two differ
    only in J2), move the case files into versioned folders, and document the
    PA12 nylon case. Update path references in the compliance and firmware docs.
2026-10-31 Warn against direct sun when placing or calibrating the unit
2026-10-31 README: photos of the assembled unit
