OxMarco/Quiesco/(notices)

Notices in the files:
README.md:
Licence: GPL v3
